intelsath/Cypher/hashbank/LCD/images/keyboard_test.png

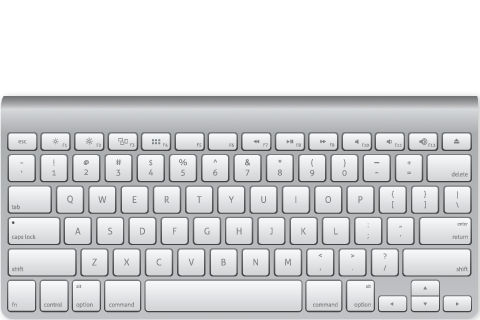
hashbank/LCD/images/keyboard_test.png
