intelsath/Cypher/hashbank_client_app/command table.docx

Hash Bank/PC | Command
Generar address bitcoin | HB_GENBTC
Generar address bitcoin cash | HB_GENBCH
Generar address litecoin | HB_GENLTC
Generar address ethereum | HB_GENETH
Generar address ripple | HB_GENXRP
Generar transaction bitcoin | HB_TXNBTC
Generar transaction bitcoin cash | HB_TXNBCH
Generar transaction litecoin | HB_TXNLTC
Generar transaction ethereum | HB_TXNETH
Generar transaction ripple | HB_TXNXRP
Volver a enviar address | HB_RSNDAD
Volver a enviar transaction | HB_RSNDTX
Enviar la cantidad de bytes que debe esperar | HB_SNDBYT
Información recibida correctamente | HB_INFOOK
