intelsath/Cypher/hashbank/LCD/images/background.png

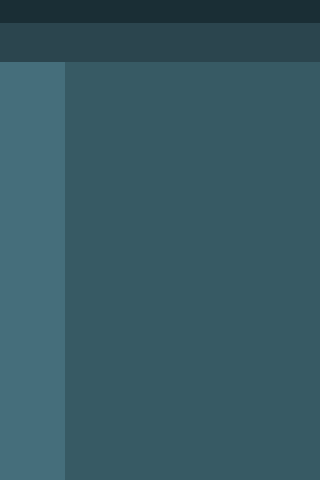
hashbank/LCD/images/background.png
