intelsath/Cypher/hashbank/LCD/images/fpscounter1.png

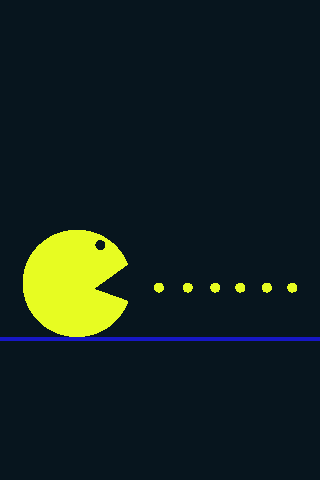
hashbank/LCD/images/fpscounter1.png
