intelsath/Cypher/hashbank_client_app/images/background.jpg

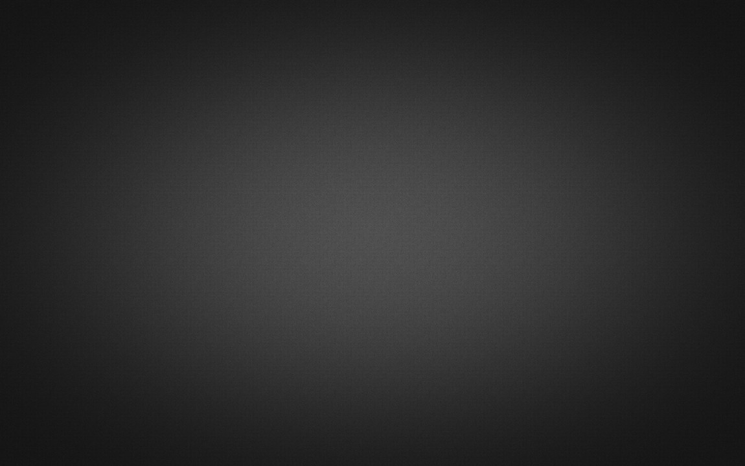
hashbank_client_app/images/background.jpg
