intelsath/Cypher/hashbank_client_app/images/bitcoin.png

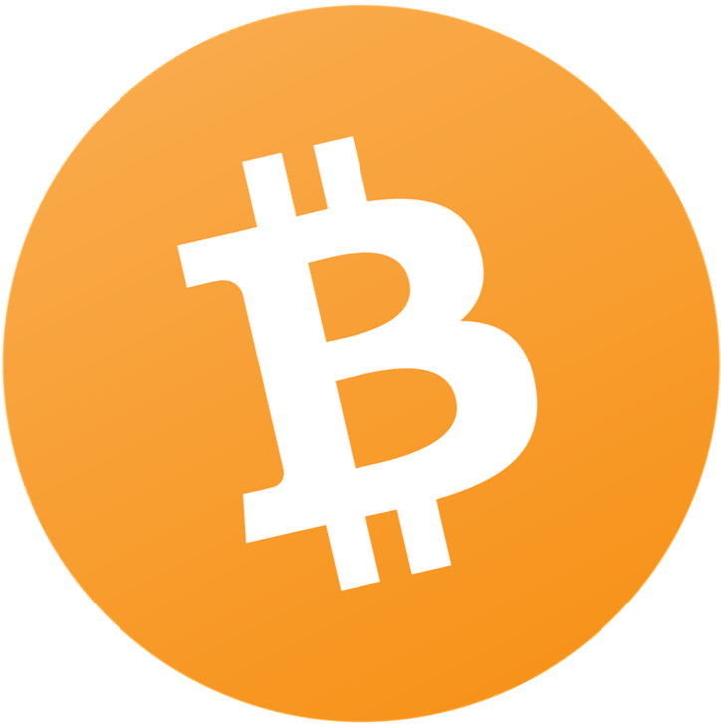
hashbank_client_app/images/bitcoin.png
