intelsath/Cypher/hashbank_client_app/images/bitcoin_cash.png

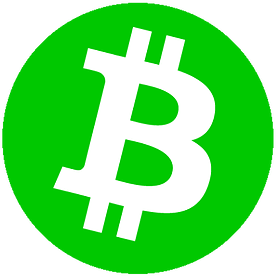
hashbank_client_app/images/bitcoin_cash.png
