intelsath/Cypher/hashbank_client_app/images/litecoin.png

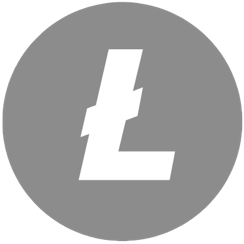
hashbank_client_app/images/litecoin.png
