intelsath/Cypher/hashbank_client_app/images/ripple.png

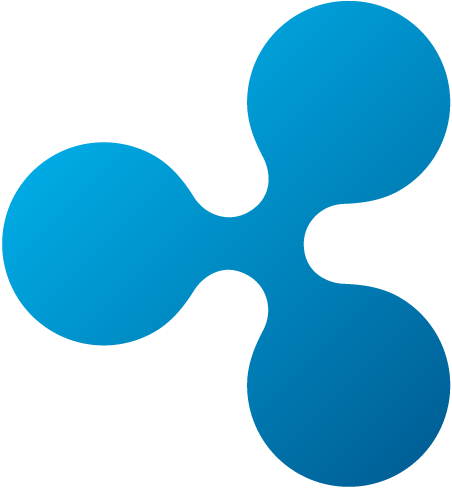
hashbank_client_app/images/ripple.png
