intelsath/Cypher/hashbank/Eagle/Cypher-BOM.xls

Qty | Part Reference | Part Number | MFGR | Distributor NO | DESCRIPTION | FOOTPRINT | DNI
2 | ANTENNA1, ANTENNA2 | 709150001030006 | AVX Corporation | 478-10942-1-ND | CONN PIN SPRING LOAD 3.0MM | B254
1 | C1 | CL05B154KO5NNNC | Samsung Electro-Mechanics | 1276-6651-1-ND | CAP CER 0.15UF 16V X7R 0402 | 0402
1 | C2 | GRM21BR60J476ME15L | Murata Electronics North America | 490-9960-1-ND | CAP CER 47UF 6.3V X5R 0805 | 0805
4 | C3, C23, C25, C34 | 02016D105KAT2A | AVX Corporation | 478-10772-1-ND | CAP CER 1UF 6.3V X5R 0201 | 0201
4 | C4, C6, C7, C14 | GRJ155R60J106ME11D | Murata Electronics North America | 490-13211-1-ND | CAP CER 10UF 6.3V X5R 0402 | 0402
1 | C5 | GRM0335C1H121JA01D | Murata Electronics North America | 490-7221-1-ND | CAP CER 120PF 50V C0G/NP0 0201 | 0201
1 | C8 | GCM033R71A103KA03D | Murata Electronics North America | 490-6040-1-ND | CAP CER 10000PF 10V X7R 0201 | 0201
8 | C9, C10, C13, C17, C18, C20, C35, C36 | CL03A104KO3NNNC | Samsung Electro-Mechanics | 1276-1319-1-ND | CAP CER 0.1UF 16V X5R 0201 | 0201
4 | C11, C12, C21, C22 | GRM0335C1H120GA01D | Murata Electronics North America | 490-11308-1-ND | CAP CER 12PF 50V C0G/NP0 0201 | 0201
3 | C15, C16, C19 | GRM033R71C222KA88D | Murata Electronics North America | 490-3190-1-ND | CAP CER 2200PF 16V X7R 0201 | 0201
1 | C24 | CL10A475KQ8NNNC | Samsung Electro-Mechanics | 1276-1045-1-ND | CAP CER 4.7UF 6.3V X5R 0603 | 0603
2 | C26, C27 | C0603C102J5RACTU | KEMET | 399-1083-1-ND | CAP CER 1000PF 50V X7R 0603 | 0603
2 | C28, C29 | TMK063CG181JTHF | Taiyo Yuden | 587-3800-1-ND | CAP CER 180PF 25V NP0 0201 | 0201
2 | C30, C31 | GRM0335C1H330GA01D | Murata Electronics North America | 490-11325-1-ND | CAP CER 33PF 50V C0G/NP0 0201 | 0201
2 | C32, C33 | CC0201JRNPO9BN820 | Yageo | 311-3684-1-ND | CAP CER 82PF 50V NPO 0201 | 0201
1 | D1 | APGA1602CGC/KA | Kingbright | 754-1820-1-ND | LED GREEN CLEAR CHIP SMD R/A | 0603
1 | J1 | ZX62-AB-5PA(31) | Hirose Electric Co Ltd | H125279CT-ND | CONN RCPT USB MICRO AB SMD R/A | Right-angle, PCB wire
1 | J2 | SM02B-SRSS-TB(LF)(SN) | JST Sales America Inc. | 455-1802-1-ND | CONN HEADER SH 2POS SIDE 1MM TIN | 2SMD, Right Angle
1 | L2 | CIG22L2R2MNE | Samsung Electro-Mechanics | 1276-6211-1-ND | FIXED IND 2.2UH 1.3A 80 MOHM SMD | 1008
1 | L1 | CIG22L4R7MNE | Samsung Electro-Mechanics | 1276-6213-1-ND | FIXED IND 4.7UH 1.1A 110 MOHM | 1008
2 | L3, L4 | LQB15NNR56J10D | Murata Electronics North America | 490-14690-1-ND | FIXED IND 560NH 300MA 730 MOHM | 0402
1 | Q1 | MMBT2222ALP4-7B | Diodes Incorporated | MMBT2222ALP4-7BDICT-ND | TRANS NPN 40V 0.6A 3DFN | X2-DFN1006-3
1 | R1 | ERJ-1GNF8063C | Panasonic Electronic Components | P123167CT-ND | RES SMD 806K OHM 1% 1/20W 0201 | 0201
1 | R2 | ERJ-1GNF1743C | Panasonic Electronic Components | P122780CT-ND | RES SMD 174K OHM 1% 1/20W 0201 | 0201
1 | R3 | ERJ-1GNJ105C | Panasonic Electronic Components | P123224CT-ND | RES SMD 1M OHM 5% 1/20W 0201 | 0201
14 | R4, R5, R9, R17, R18, R19, R20, R21, R22, R23, R24, R25, R26, R27 | ERJ-1GNJ103C | Panasonic Electronic Components | P123222CT-ND | RES SMD 10K OHM 5% 1/20W 0201 | 0201
2 | R6, R14 | ERJ-1GNF1603C | Panasonic Electronic Components | P122760CT-ND | RES SMD 160K OHM 1% 1/20W 0201 | 0201
2 | R7, R12 | ERJ-1GNF2403C | Panasonic Electronic Components | P122859CT-ND | RES SMD 240K OHM 1% 1/20W 0201 | 0201
1 | R8 | ERJ-2GEJ161X | Panasonic Electronic Components | P160JCT-ND | RES SMD 160 OHM 5% 1/10W 0402 | 0402
1 | R10 | ERJ-1GNF1001C | Panasonic Electronic Components | P122413CT-ND | RES SMD 1K OHM 1% 1/20W 0201 | 0201
1 | R11 | ERJ-1GNF7503C | Panasonic Electronic Components | P123152CT-ND | RES SMD 750K OHM 1% 1/20W 0201 | 0201
1 | R13 | ERJ-1GNF8453C | Panasonic Electronic Components | P123182CT-ND | RES SMD 845K OHM 1% 1/20W 0201 | 0201
1 | R15 | ERJ-1GNF5903C | Panasonic Electronic Components | P123092CT-ND | RES SMD 590K OHM 1% 1/20W 0201 | 0201
1 | R16 | ERJ-1GNF4123C | Panasonic Electronic Components | P122999CT-ND | RES SMD 412K OHM 1% 1/20W 0201 | 0201
2 | R28, R29 | ERJ-1GNF1501C | Panasonic Electronic Components | P122743CT-ND | RES SMD 1.5K OHM 1% 1/20W 0201 | 0201
1 | R30, R31 | ERJ-2GEJ152X | Panasonic Electronic Components | P1.5KJCT-ND | RES SMD 1.5K OHM 5% 1/10W 0402 | 0402
1 | RN1 | EXB-V4V102JV | Panasonic Electronic Components | Y2102CT-ND | RES ARRAY 2 RES 1K OHM 0606 | 0606
1 | RN2 | EXB-N8V100JX | Panasonic Electronic Components | Y10100CT-ND | RES ARRAY 4 RES 10 OHM 0804 | 2012
1 | S1 | EVQ-P7J01P | Panasonic Electronic Components | P16767CT-ND | SWITCH TACTILE SPST-NO 0.05A 12V | SPST-NO
1 | U1 | LTC2954CDDB-1#TRMPBF | Linear Technology/Analog Devices | LTC2954CDDB-1#TRMPBFCT-ND | IC PUSH BUTTON ON/OFF CTRLR 8DFN | 8DFN (3x2)
1 | U2 | LTC3558EUD#PBF | Linear Technology/Analog Devices | LTC3558EUD#PBF-ND | IC USB BATTERY CHARGER 20-QFN | 20QFN (3x3)
1 | U3 | FT232RQ-REEL | FTDI, Future Technology Devices International Ltd | 768-1008-1-ND | IC USB FS SERIAL UART 32-QFN | 32QFN (5x5)
1 | U4 | OSD3358-512M-BSM | Octavo Systems LLC | 1676-1002-ND | SiP (AM335x, TPS65217C PMIC, TI TL5209 LDO) 21mm 256 BALL BGA | 256BGA (21x21)
1 | U5 | SN74LVC1G07DSFR | Texas Instruments | 296-29520-1-ND | IC BUFFER NON-INVERT 5.5V 6SON | 6-SON (1x1)
1 | U7 | LSM6DS33TR | STMicroelectronics | 497-15996-1-ND | IMU ACCEL/GYRO I2C/SPI 16LGA | 16-LGA (3x3)
1 | U6 | AT97SC3205T-G3M4C-10 | Microchip Technology | AT97SC3205T-G3M4C-10CT-ND | FF COM I2C TPM 4X4 32VQFN UEK | 32VQFN(4x4)
1 | U8 | PN7150B0HN/C11002E | NXP USA Inc. | 568-13911-ND | RFID Reader IC 13.56MHz HVQFN | 40-VFQFN (6x6)
1 | XU1 | DF37B-10DP-0.4V(53) | Hirose Electric Co Ltd | H11832CT-ND | CONN HDR 10POS 0.4MM SMD GOLD
1 | XU2 | 62684-502100ALF | Amphenol FCI | 609-1202-1-ND | LCD FPC/FFC Connector 0.5mm pitch 50 pin TOP | SMD 50 pins 0.5mm pitch
1 | XU3 | 0472192001 | Molex, LLC | WM6698CT-ND | CONN MICRO SD CARD HINGED TYPE | 8pos microSD
1 | Y1 | TSX-3225 24.0000MF15X-AC6 | EPSON | SER4180CT-ND | CRYSTAL 24.00 MHZ 9.0PF SMD | 4SMD
1 | Y2 | XRCGB27M120F3M10R0 | Murata Electronics North America | 490-8578-1-ND | CRYSTAL 27.1200MHZ 10PF SMD | 4SMD
