intelsath/Cypher/Hardware/Inventor/Button Cap void.stl

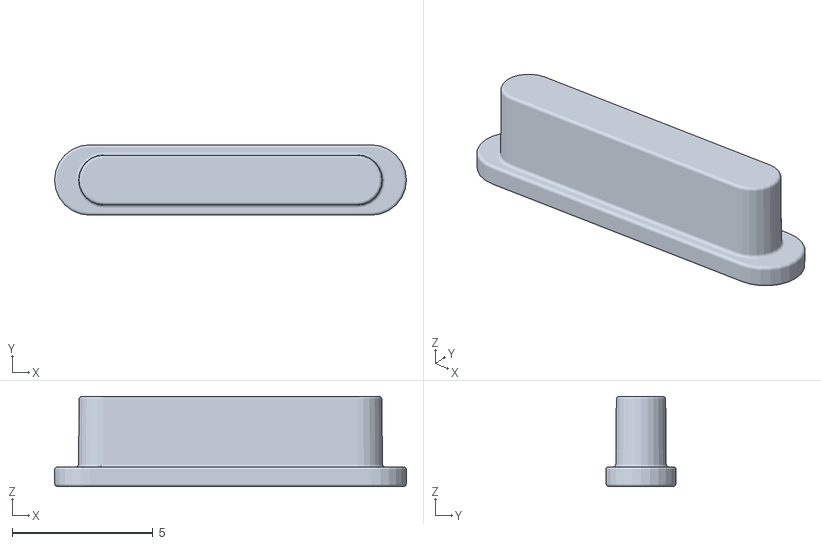
[picture p9: CAD file, 2020-03-15]
Hardware/Inventor/Button Cap void.stl
12.5 x 2.50 x 3.20
