intelsath/Cypher/Hardware/Inventor/Casing for cover.stp

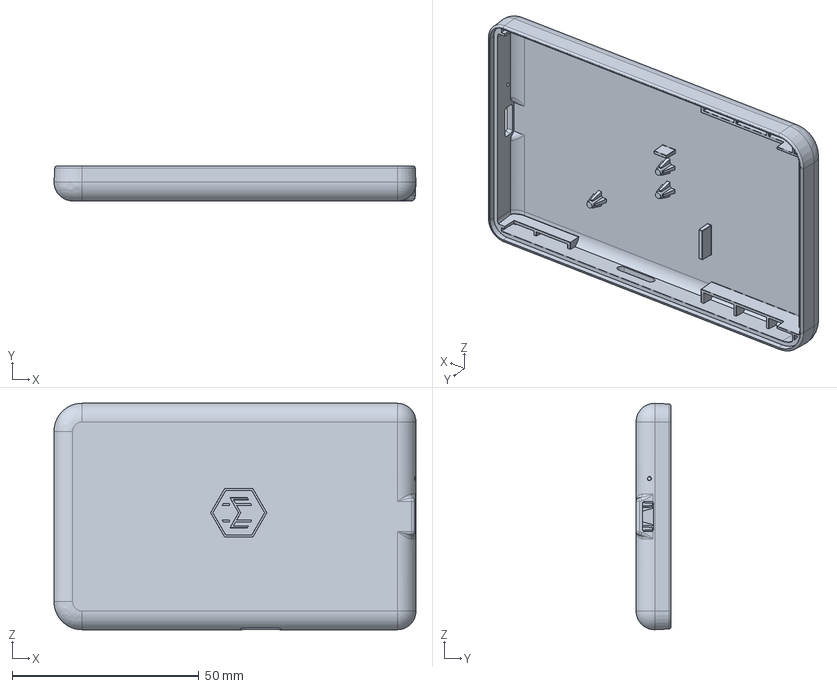
[picture p10: CAD file, 2020-03-15]
Hardware/Inventor/Casing for cover.stp
96.8 x 9.32 x 60.6 mm
