intelsath/Cypher/(list of files, cad)

Other CAD files:
Hardware/Inventor/Button Cap.stp
Hardware/Inventor/LCD+Cover.dwg
Hardware/Inventor/OldVersions/LCD+Cover.0003.dwg
Hardware/Inventor/0603 LED v7.ipt
Hardware/Inventor/Antenna.ipt
Hardware/Inventor/Assembled_PCB.iam
Hardware/Inventor/Battery.ipt
Hardware/Inventor/Button Cap.ipt
Hardware/Inventor/Button Cap.stl
Hardware/Inventor/Casing (Back).ipt
Hardware/Inventor/Casing for cover.ipt
Hardware/Inventor/Casing for cover.stl
Hardware/Inventor/ColdStorageCasing.iam
Hardware/Inventor/Crystal 3225.ipt
Hardware/Inventor/LCD+Cover.ipt
Hardware/Inventor/LCD-Connector.ipt
Hardware/Inventor/LCD-cable.ipt
Hardware/Inventor/LCD.ipt
Hardware/Inventor/LED Pipe.ipt
Hardware/Inventor/MegahashColdStorage.iam
Hardware/Inventor/MegahashColdStorage_V3.iam
Hardware/Inventor/MicroSD-holder.ipt
Hardware/Inventor/Multi-Inno_3.5in_LCD.ipt
Hardware/Inventor/OldVersions/0603 LED v7.0001.ipt
Hardware/Inventor/OldVersions/Antenna.0001.ipt
Hardware/Inventor/OldVersions/Assembled_PCB.0011.iam
Hardware/Inventor/OldVersions/Battery.0009.ipt
Hardware/Inventor/OldVersions/Button Cap.0016.ipt
Hardware/Inventor/OldVersions/Casing (Back).0084.ipt
Hardware/Inventor/OldVersions/Casing (Front).0019.ipt
Hardware/Inventor/OldVersions/Casing for cover.0059.ipt
Hardware/Inventor/OldVersions/ColdStorageCasing.0002.iam
Hardware/Inventor/OldVersions/CryptoWallet.0050.iam
Hardware/Inventor/OldVersions/LCD+Cover.0006.ipt
Hardware/Inventor/OldVersions/LCD.0002.ipt
Hardware/Inventor/OldVersions/LCD.0005.iam
Hardware/Inventor/OldVersions/LED Pipe.0003.ipt
Hardware/Inventor/OldVersions/MegahashColdStorage.0019.iam
Hardware/Inventor/OldVersions/MegahashColdStorage_V3.0025.iam
Hardware/Inventor/OldVersions/Multi-Inno_3.5in_LCD.0002.ipt
Hardware/Inventor/OldVersions/PCB.0014.ipt
Hardware/Inventor/OldVersions/Push-button.0002.ipt
Hardware/Inventor/OldVersions/SiP.0006.ipt
Hardware/Inventor/OldVersions/Test.0002.ipt
Hardware/Inventor/OldVersions/Touchcreen+Cover.0002.ipt
Hardware/Inventor/OldVersions/micro_usb_connector.0004.iam
Hardware/Inventor/PCB.ipt
Hardware/Inventor/Pogo-pin.ipt
Hardware/Inventor/Push-button.ipt
Hardware/Inventor/QFN-24 3x3 0.4mm.ipt
Hardware/Inventor/QFN24(4X4).ipt
Hardware/Inventor/QFN32.ipt
Hardware/Inventor/RightAngleLED.ipt
Hardware/Inventor/SHR-02V-S-B.ipt
Hardware/Inventor/SM02B-SRSS-TB.ipt
Hardware/Inventor/SiP.ipt
Hardware/Inventor/Touchcreen+Cover.ipt
Hardware/Inventor/Touchscreen_Connector.ipt
Hardware/Inventor/micro_usb_connector.iam
Hardware/Inventor/shield.ipt
Hardware/Inventor/socket_housing.ipt
Hardware/Inventor/socket_plate.ipt
Hardware/Inventor/terminal.ipt
