intelsath/Cypher/Hardware/Inventor/LCD+Cover.pdf

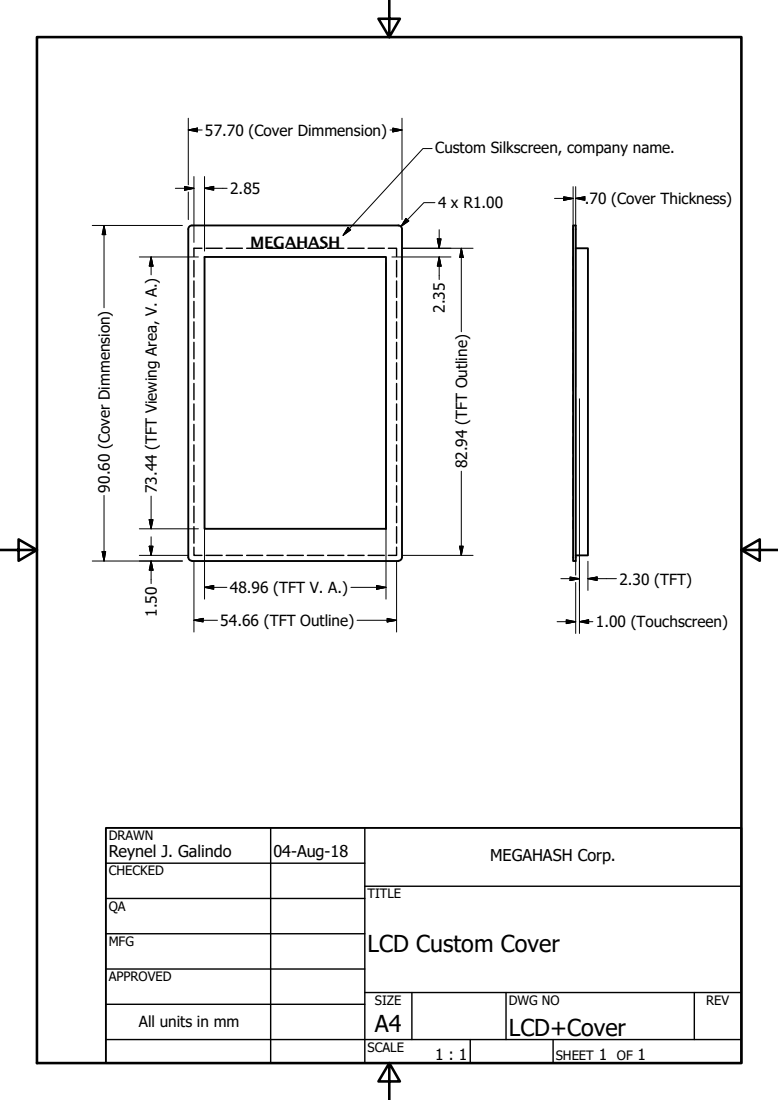
[picture p15: page 1]
SHEET 1 OF 1; DRAWN; CHECKED; MFG; APPROVED; Reynel J. Galindo; 04-Aug-18; DWG NO LCD+Cover; TITLE; SIZE A4; SCALE; MEGAHASH Corp.; REV; 54.66 (TFT Outline); utlin; Vie; win; Are; 48.96 (TFT V. A.); er Dim; sio; 57.70 (Cover Dimmension); 2.30 (TFT); 1.00 (Touchscreen); .70 (Cover Thickness); MEGAHASH

Custom Silkscreen, company name.

LCD Custom Cover

All units in mm
