intelsath/Cypher/Hardware/Eagle/Cypher v0.3/Cypher - v0.3 - Assembly drawing.pdf

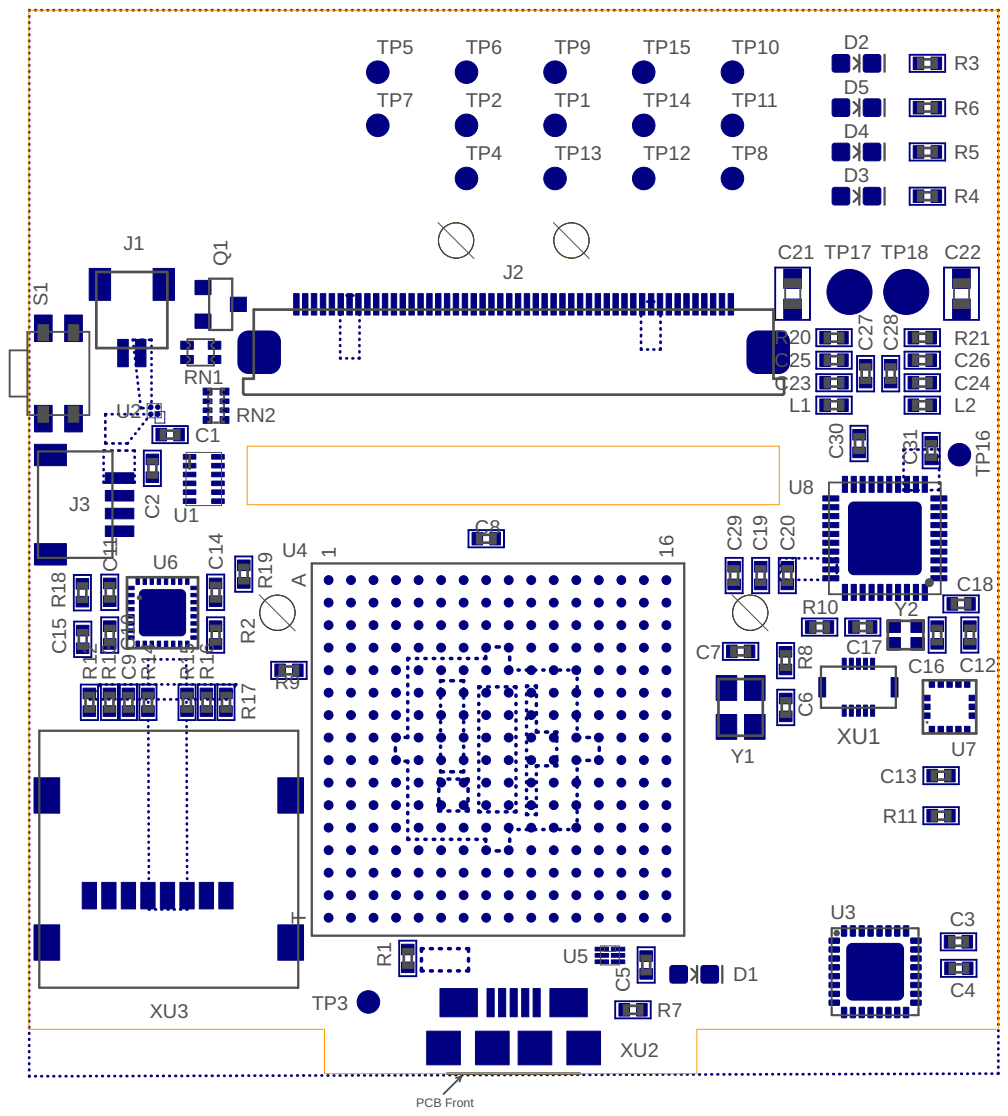
[picture p16: page 1]
