intelsath/Cypher/Hardware/Eagle/Cypher v0.3/Cypher - V0.3.bot.pdf

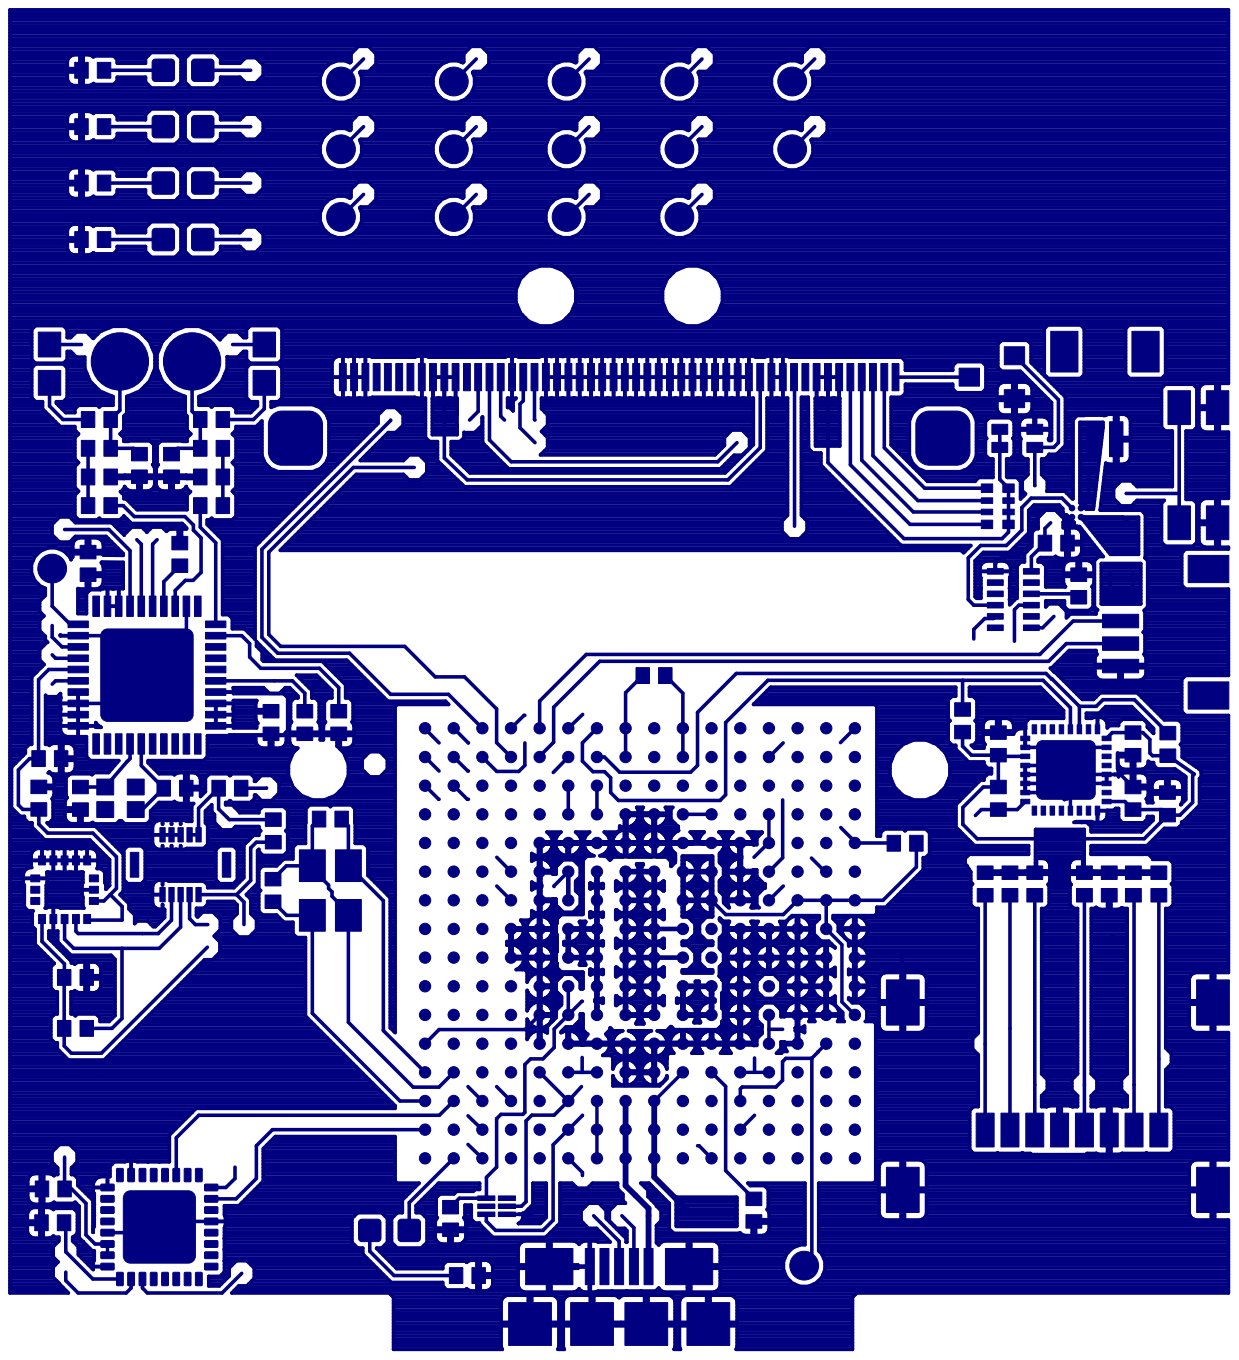
[picture p17: page 1]
