intelsath/Cypher/Hardware/Eagle/Cypher v0.3/Cypher - V0.3.signal.pdf

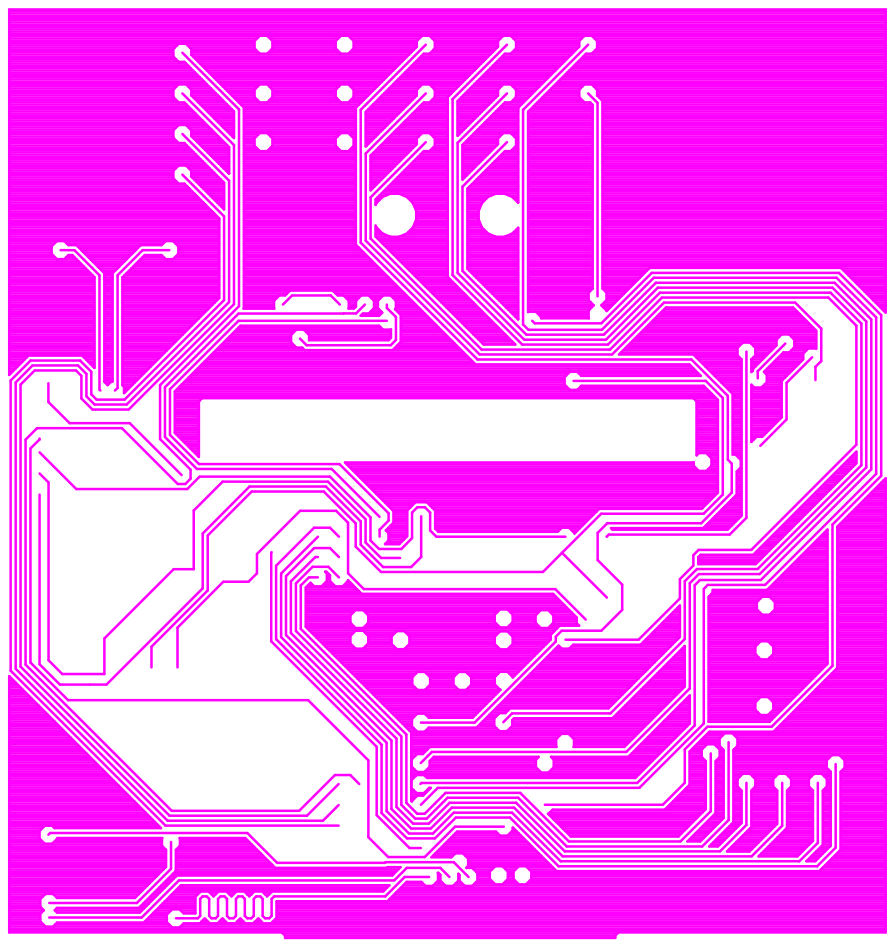
[picture p18: page 1]
