intelsath/Cypher/Hardware/Eagle/Cypher v0.3/Cypher - V0.3.top.pdf

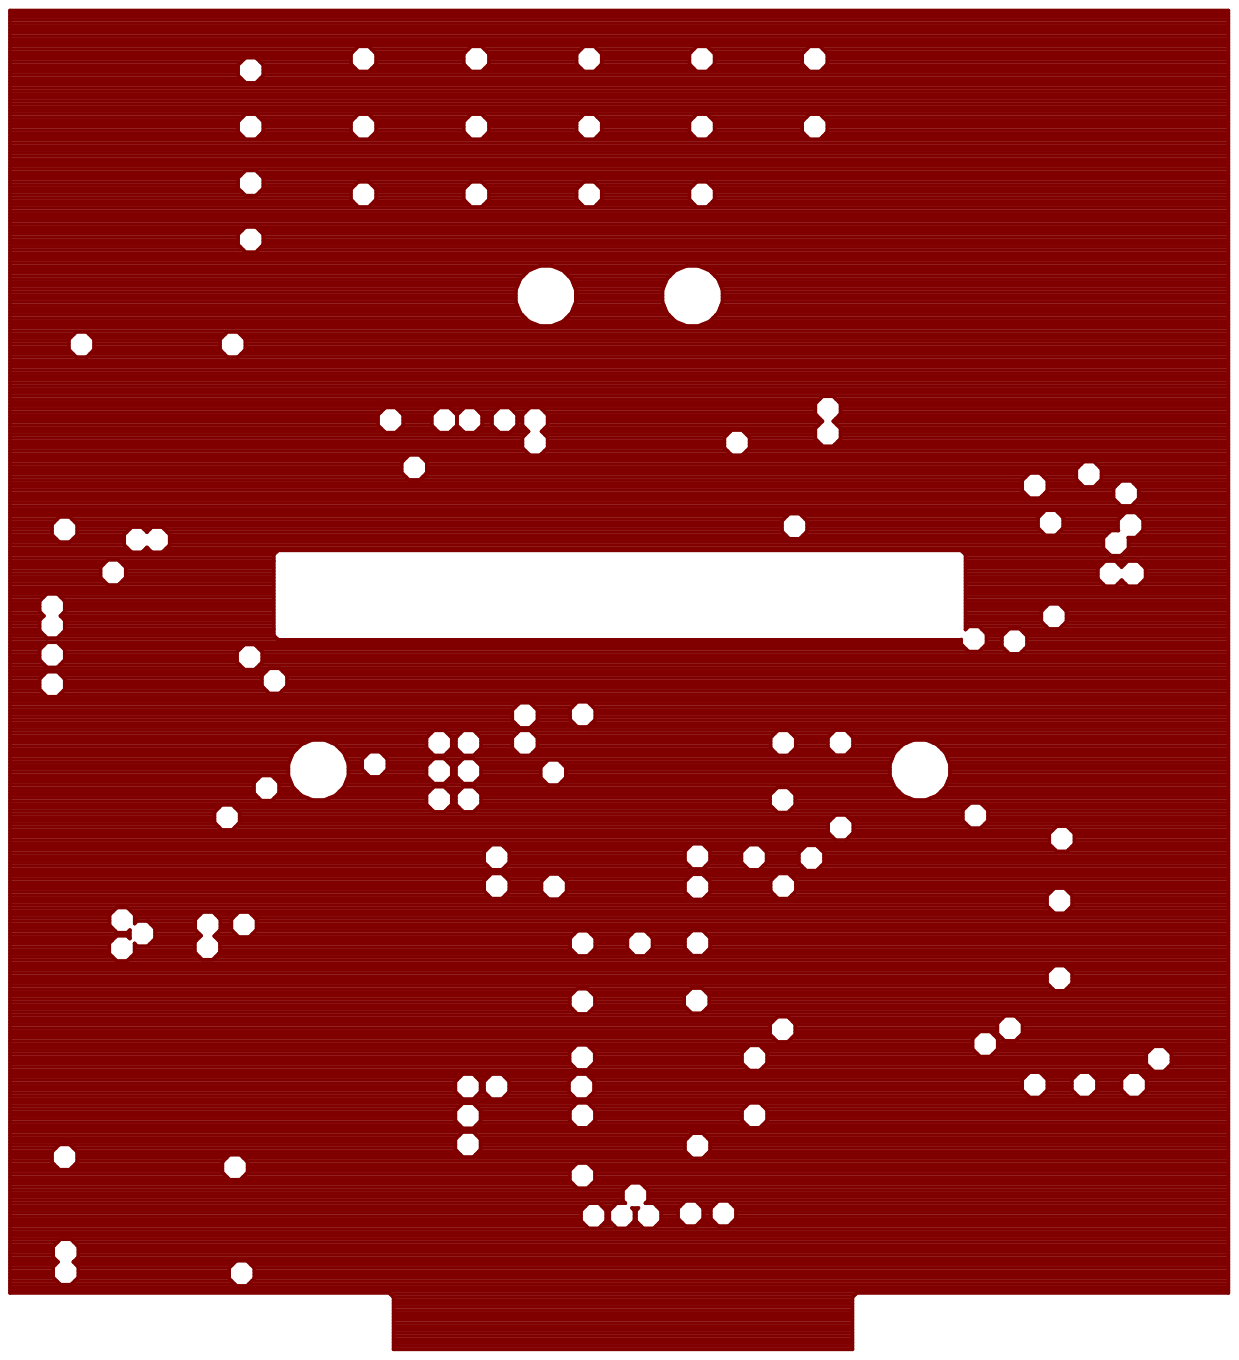
[picture p19: page 1]
