intelsath/Cypher/Hardware/Eagle/Cypher v0.3/Cypher - V0.3.vcc.pdf

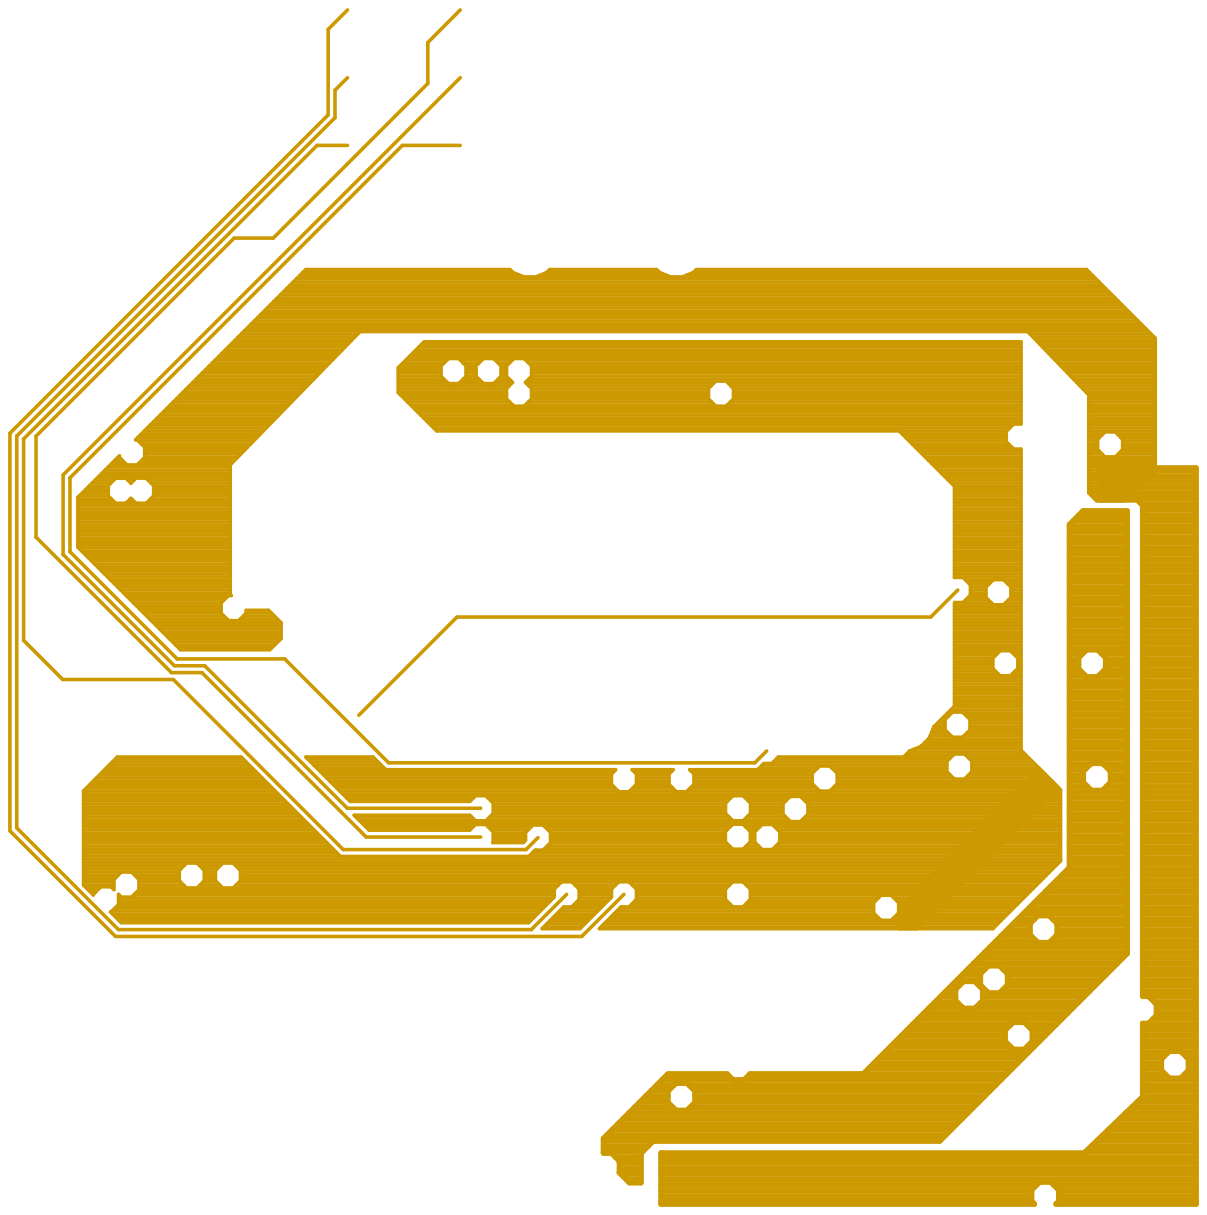
[picture p20: page 1]
