intelsath/Cypher/Hardware/Eagle/Cypher v0.3/Cypher - V1.3.1.pdf

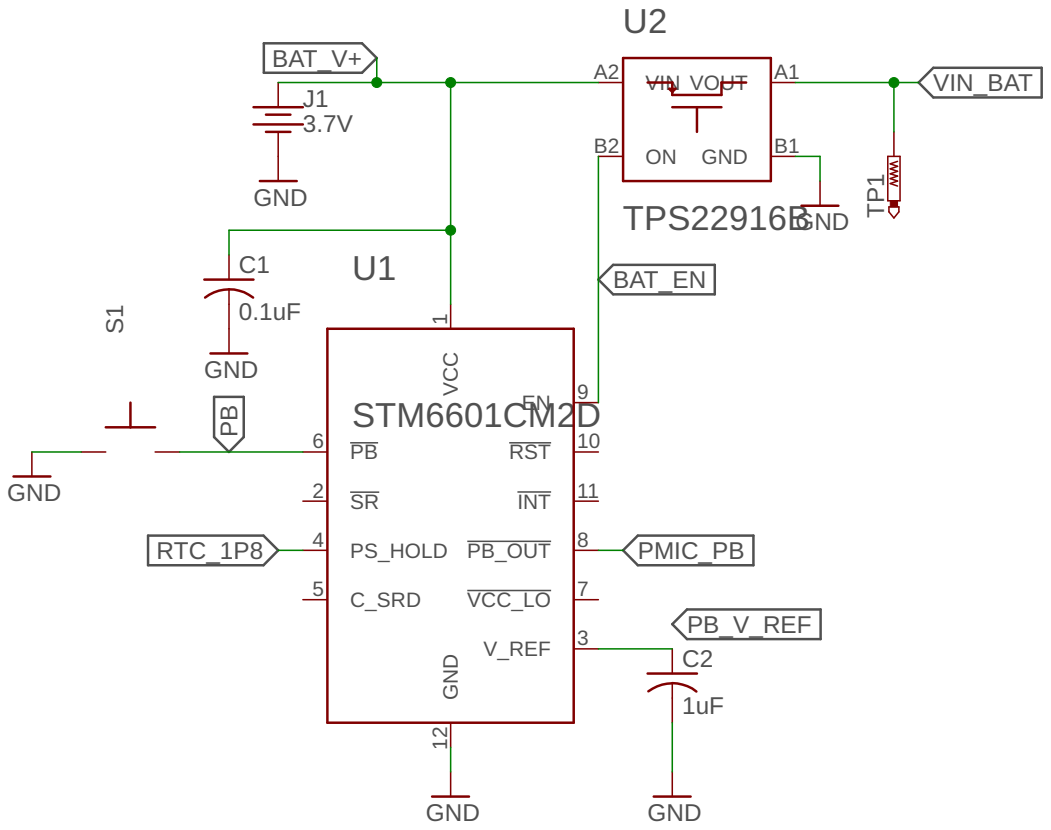
[picture p21: page 1]

REV:

Date: 21-Feb-19 4:08 PM | Sheet: 1/1
