intelsath/Cypher/Hardware/Eagle/Cypher v0.3/Cypher - V0.3.6.pdf

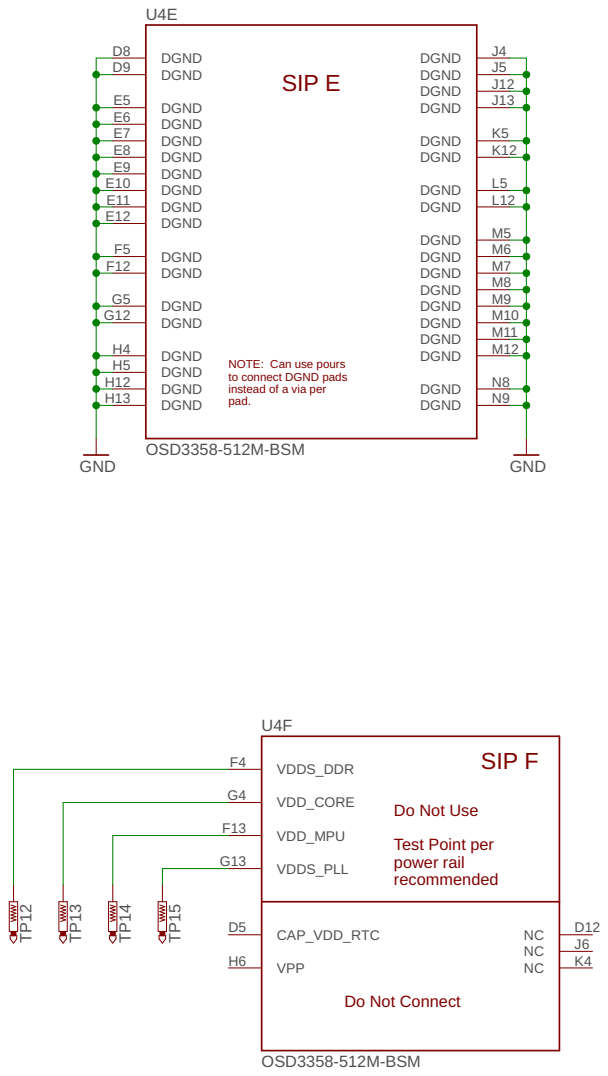
[picture p22: page 1]

D9 | J5
E5 | J12

E8 | K12
E9 | L5

NOTE: Can use pours
to connect DGND pads
instead of a via per pad.

Do Not Use Test Point per power rail recommended

Document Number: | REV:

Date: 21-Feb-19 4:08 PM | Sheet: 1/1
