intelsath/Cypher/Hardware/Eagle/Cypher v0.3/Cypher - V0.3.1.pdf

REV:

Date: 21-Feb-19 4:08 PM | Sheet: 1/1
