intelsath/Cypher/Hardware/Eagle/Cypher v0.3/Cypher - V0.3.3.pdf

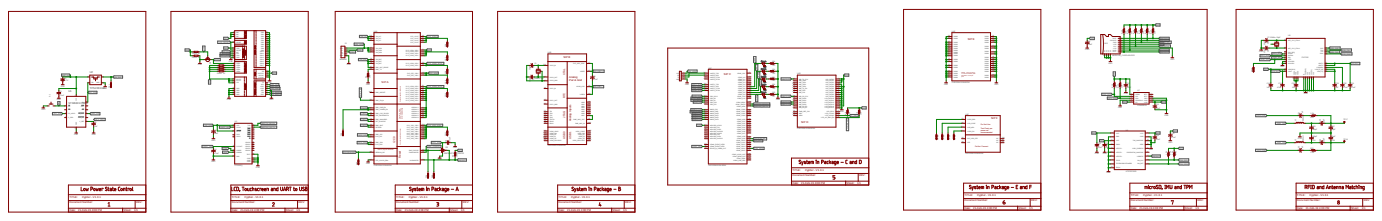
[picture p23: page 1]
