intelsath/Cypher/Hardware/Eagle/Cypher v0.3/Cypher - V0.3.5.pdf

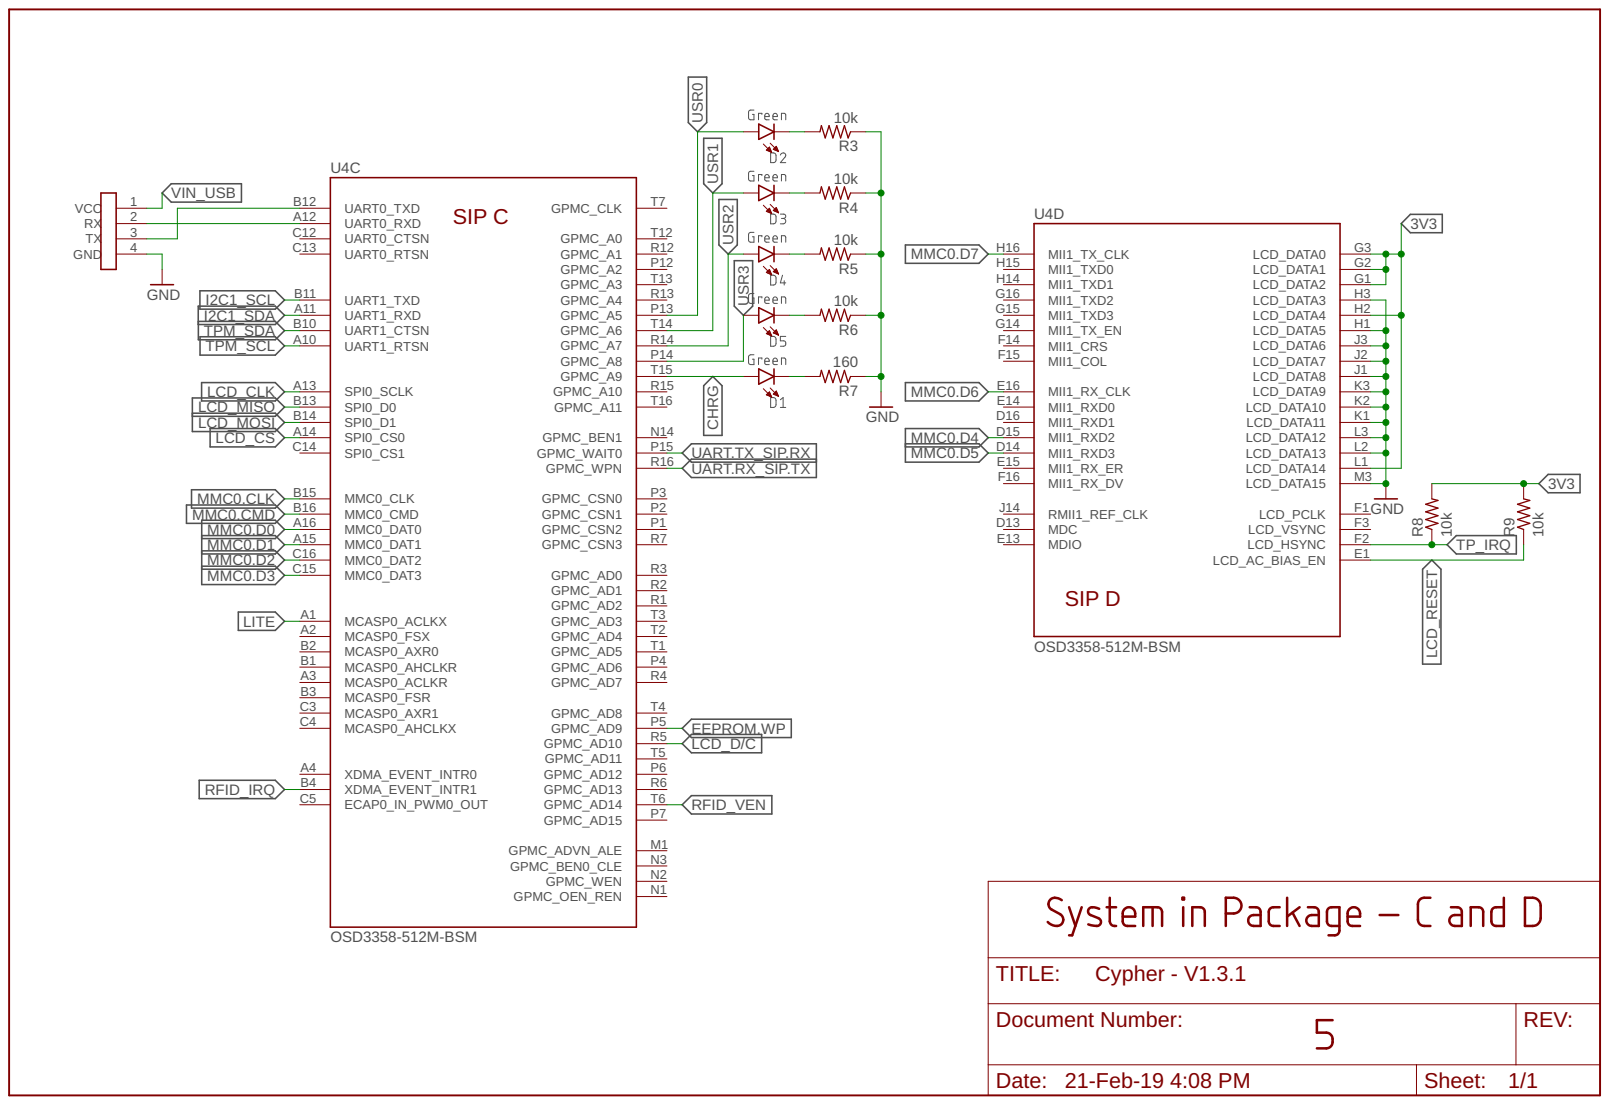
[picture p24: page 1]

REV:

Date: 21-Feb-19 4:08 PM | Sheet: 1/1
