intelsath/Cypher/Hardware/Eagle/Cypher v0.3/Cypher - V0.3.8.pdf

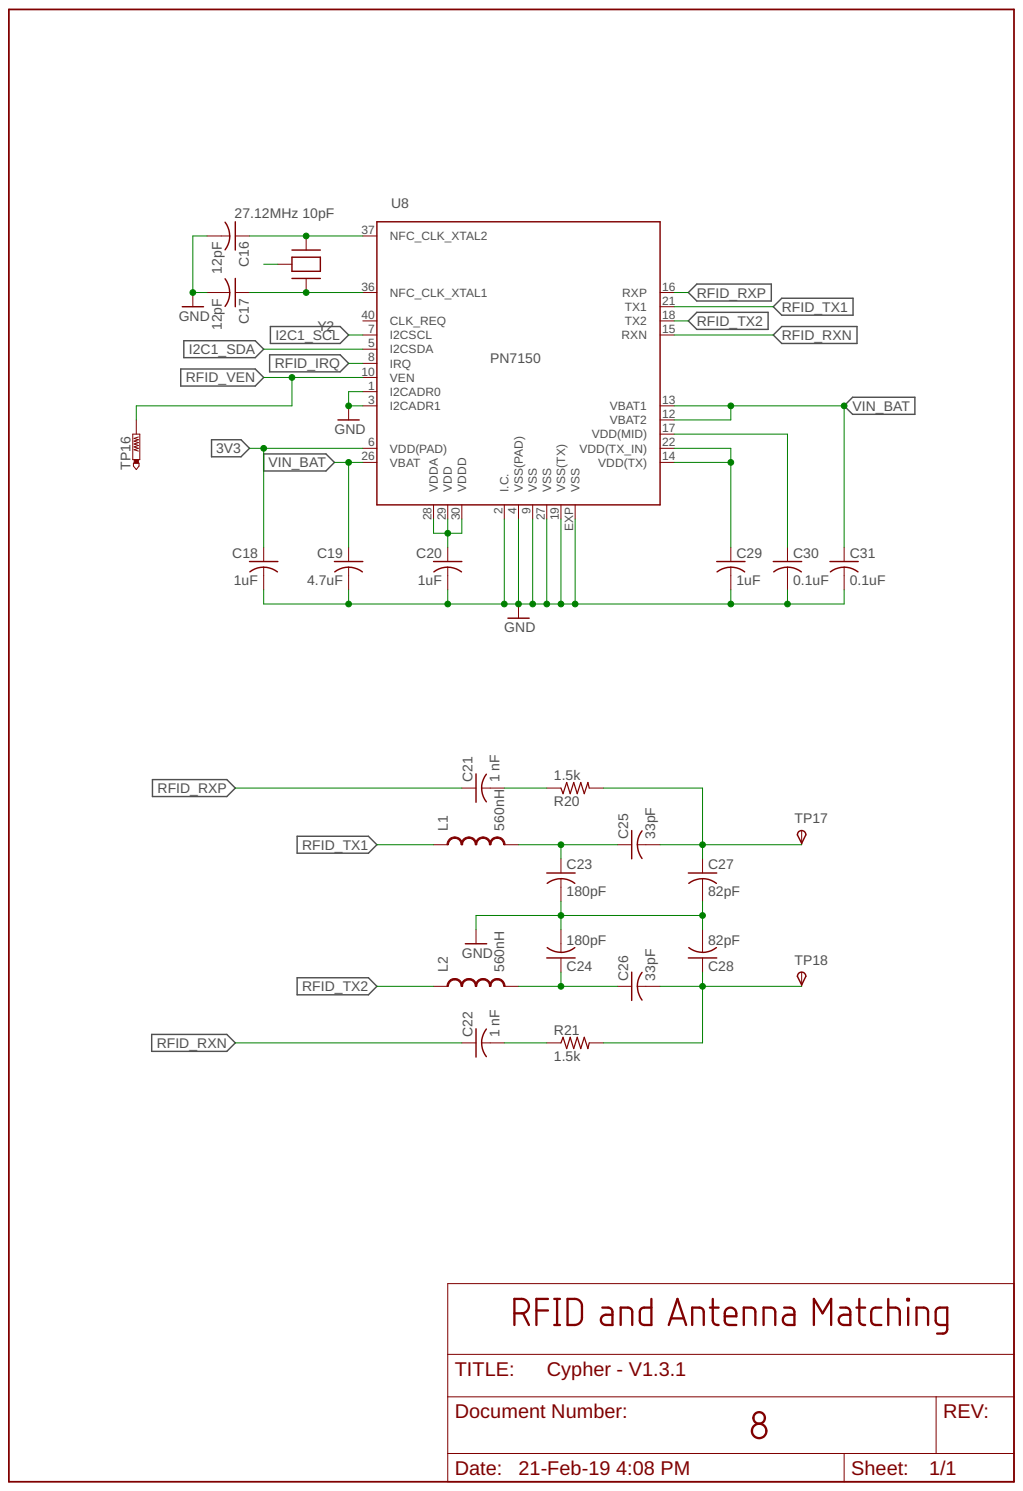
[picture p25: page 1]

27 VSS(TX) 19 VDD(TX) 14 VDD(TX_IN) 22 VDD(MID) 17 VBAT2

Document Number: | REV:

Date: 21-Feb-19 4:08 PM | Sheet: 1/1
