intelsath/Cypher/hashbank/Eagle/Cypher.brd

## EAGLE design hashbank/Eagle/Cypher.brd (2020-03-15)

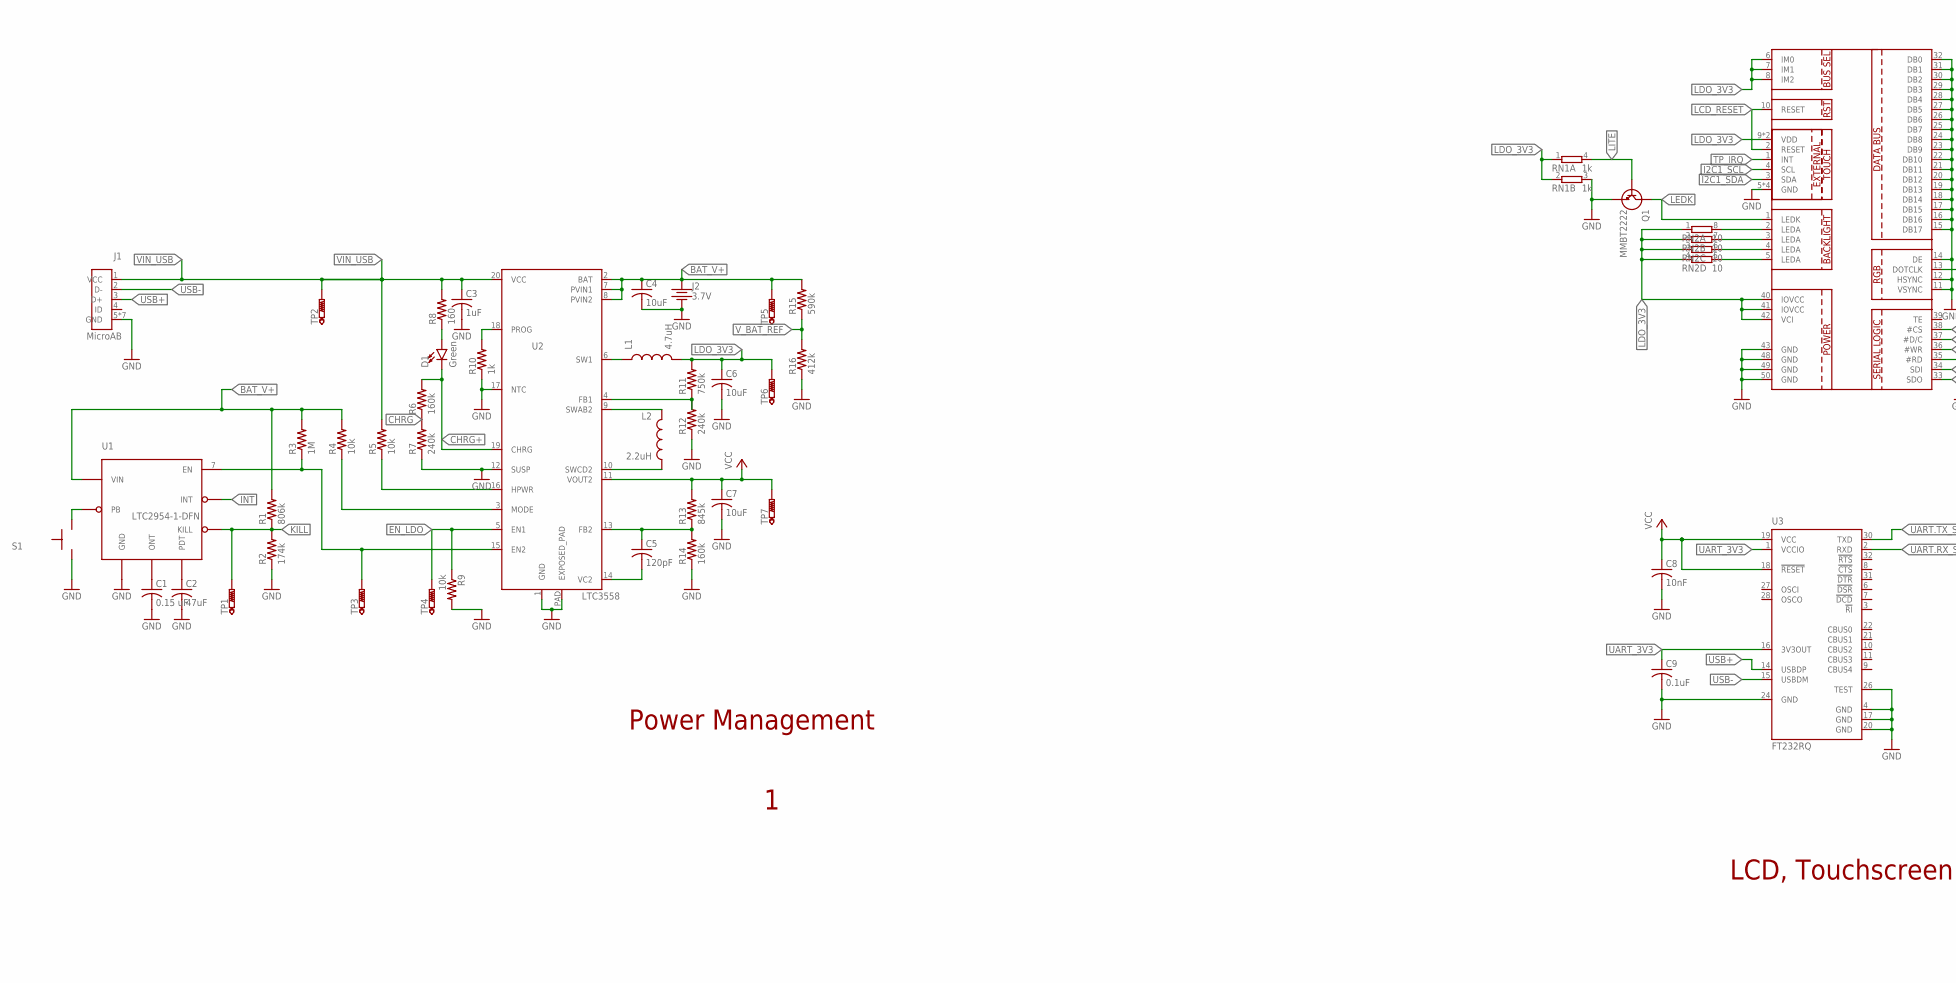
[picture p26: schematic Cypher.sch, part in row 1, column 1]

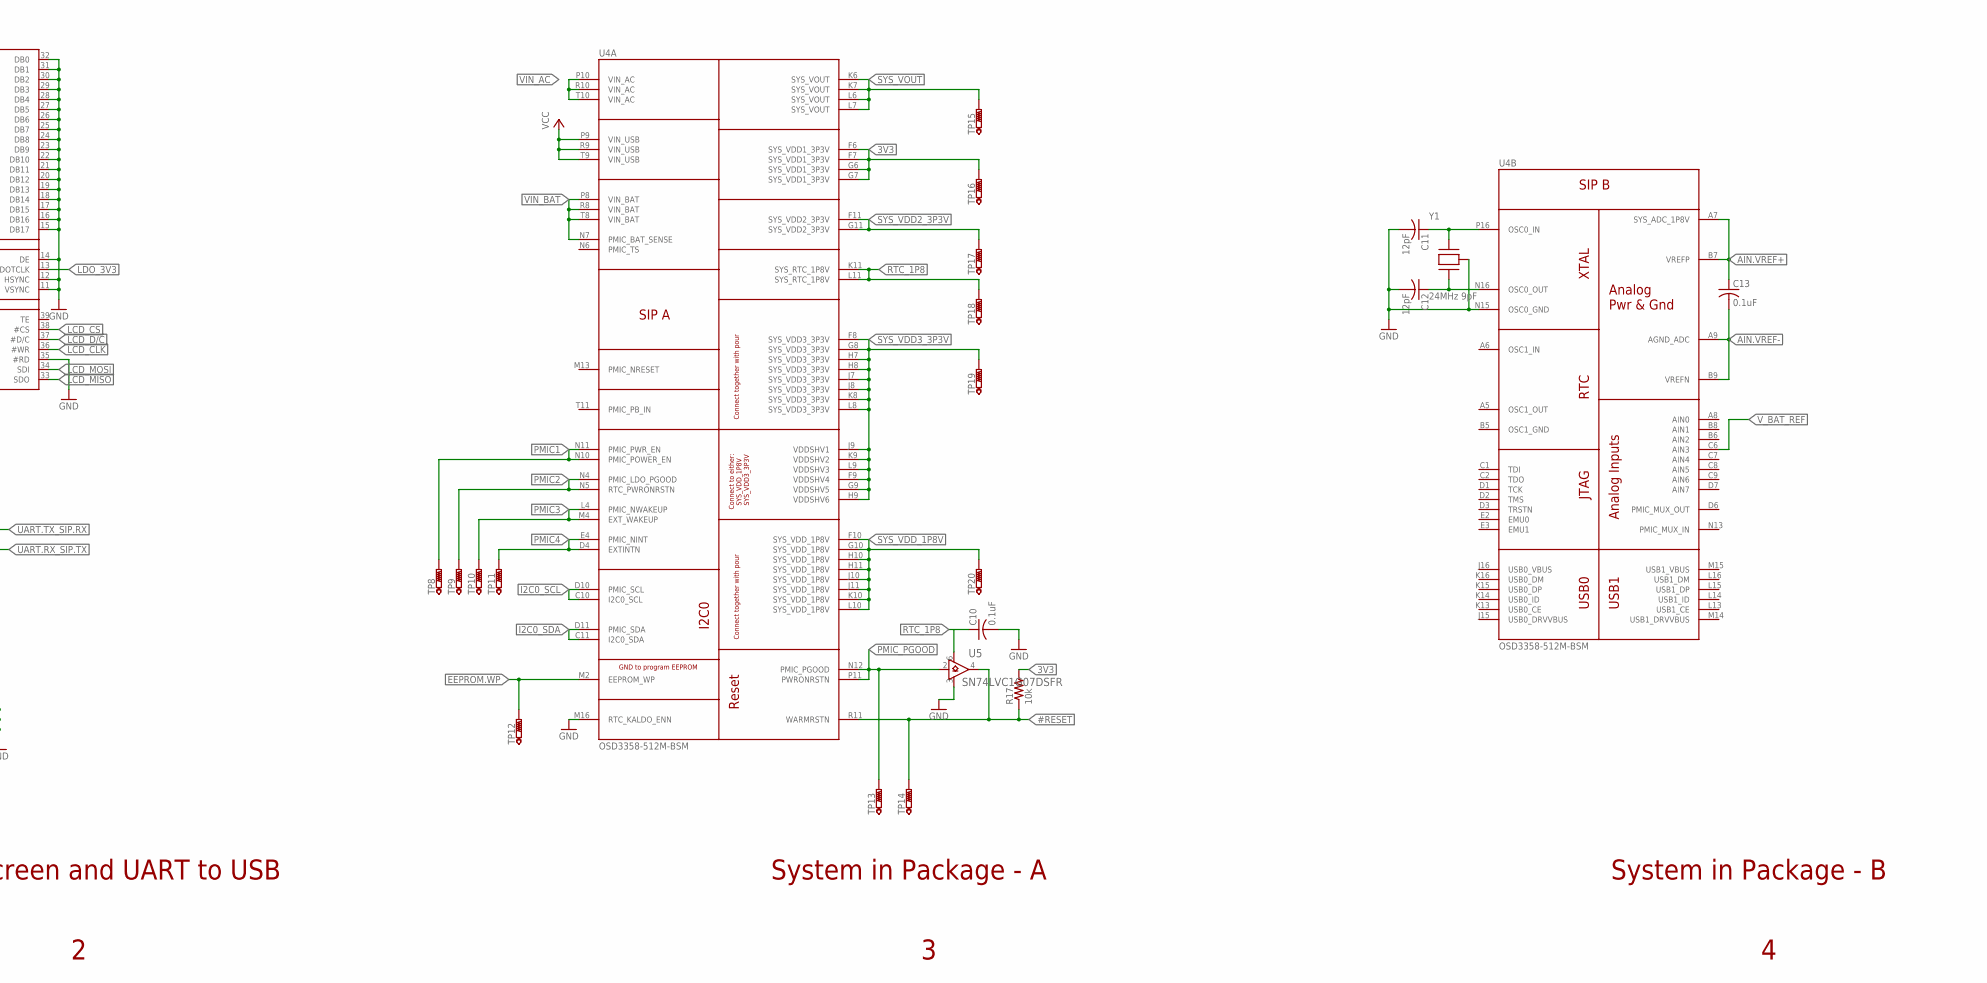
[picture p27: schematic Cypher.sch, part in row 1, column 2]

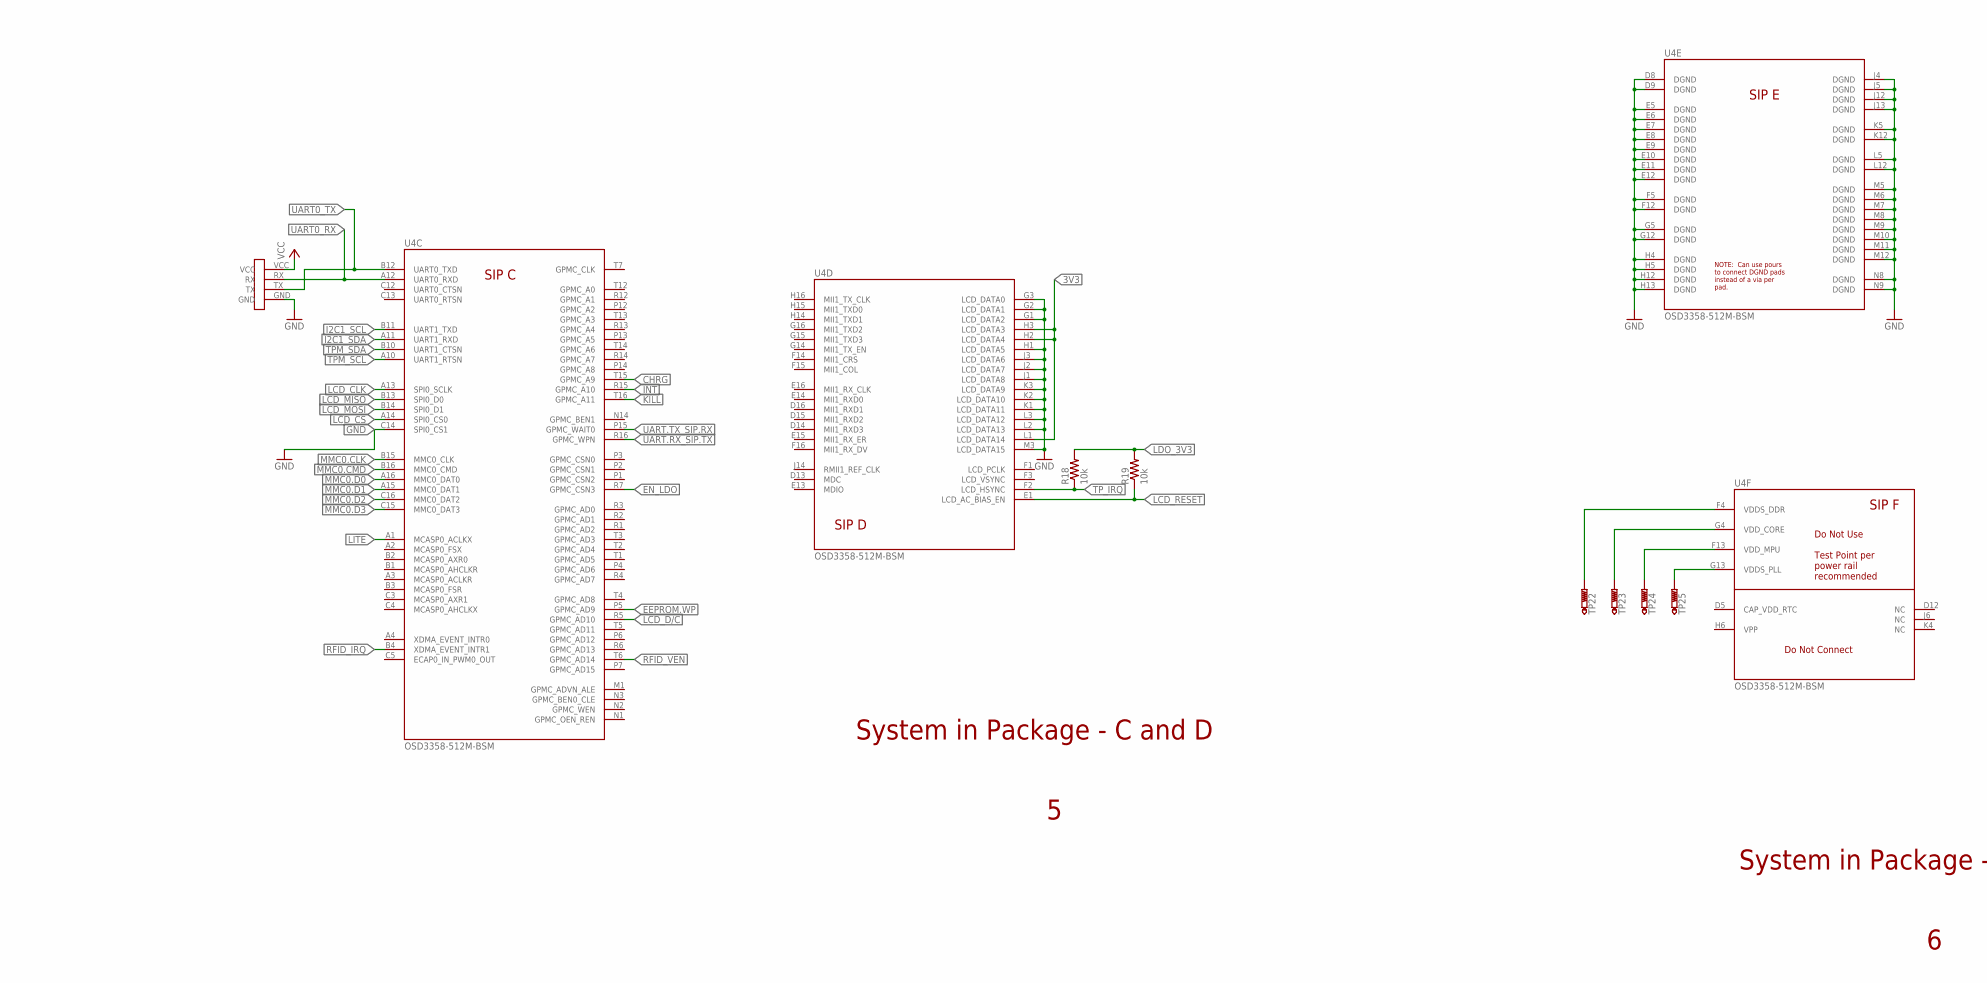
[picture p28: schematic Cypher.sch, part in row 1, column 3]

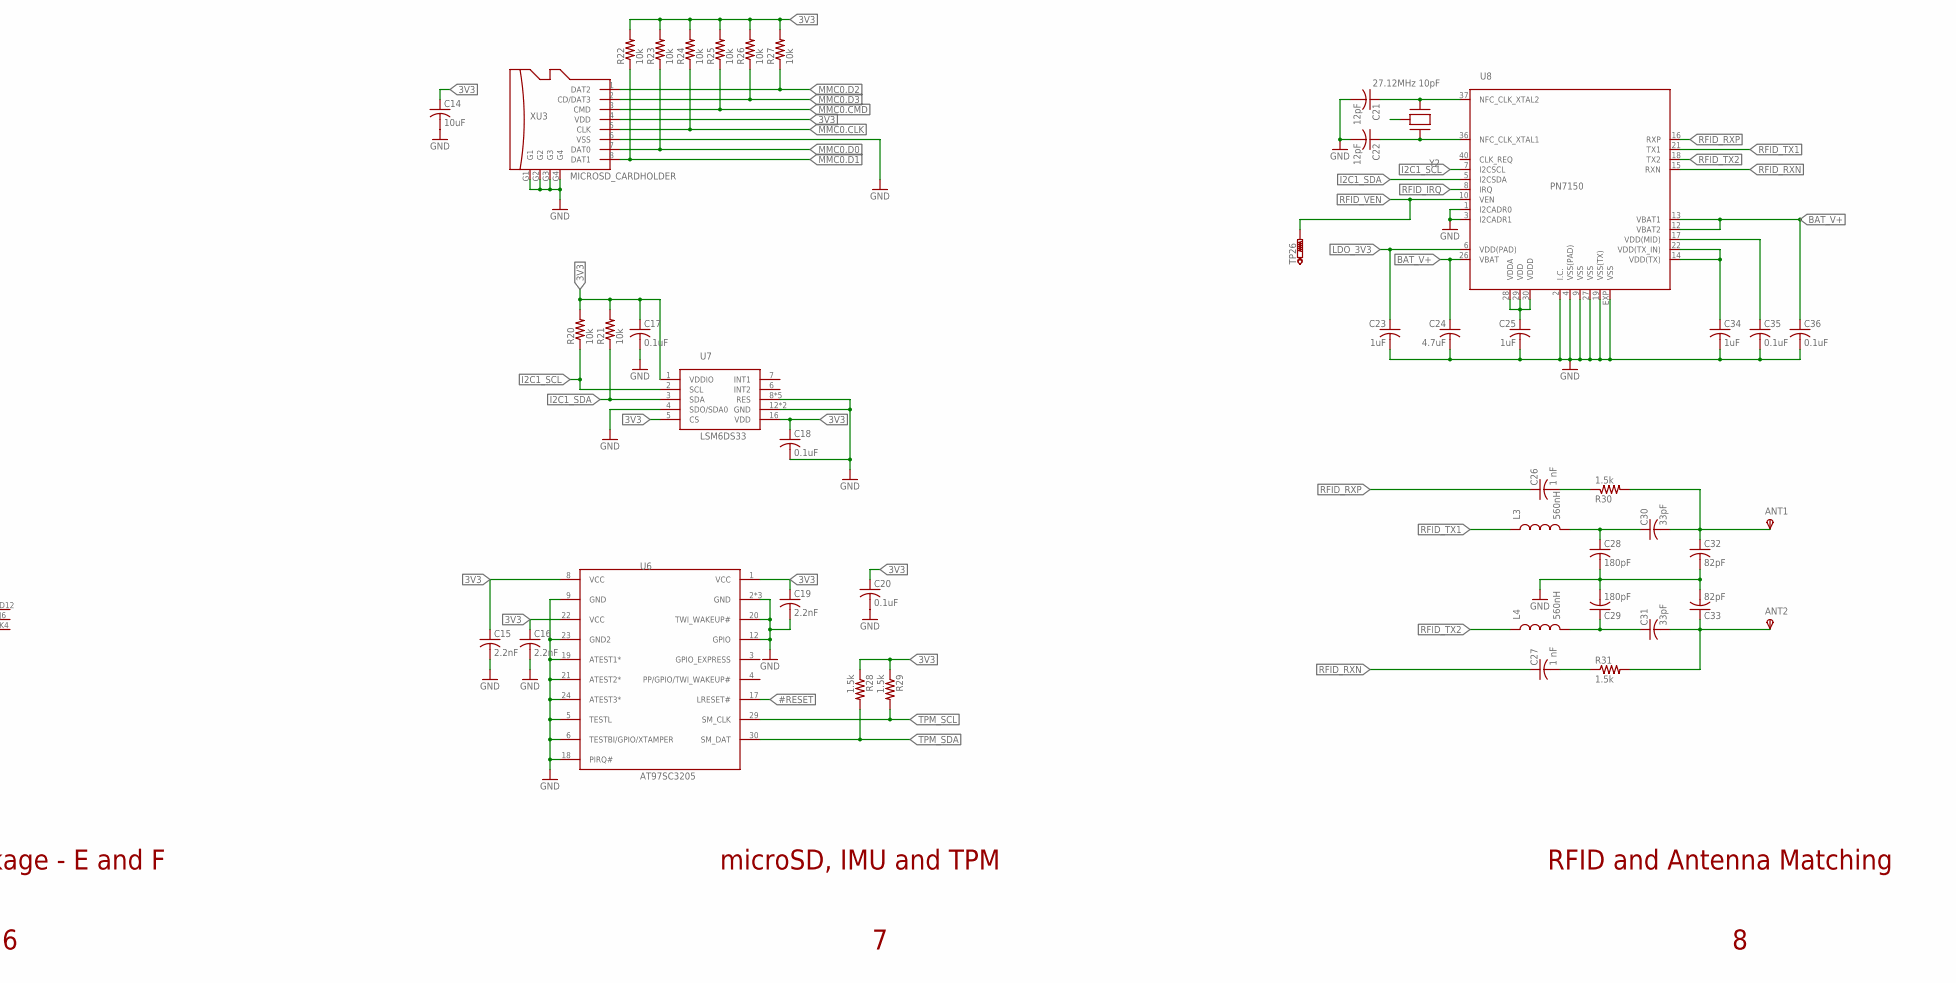
[picture p29: schematic Cypher.sch, part in row 1, column 4]

Parts:
ANT1, ANT2: TPSB2,54; B2,54
C1: 0.15 uF; C0402
C2: 47uF; C0805
C3, C23, C25, C34: 1uF; C0201
C4, C6, C7, C14: 10uF; C0402
C5: 120pF; C0201
C8: 10nF; C0201
C9, C10, C13, C17, C18, C20, C35, C36: 0.1uF; C0201
C11, C12, C21, C22: 12pF; C0201
C15, C16, C19: 2.2nF; C0201
C24: 4.7uF; C0603
C26, C27: 1 nF; C0603
C28, C29: 180pF; C0201
C30, C31: 33pF; C0201
C32, C33: 82pF; C0201
D1: Green; LED-0603
J1: MicroAB; MICRO-USB-AB-SMD
J2: 3.7V; SH_CONNECTOR
L1: 4.7uH; L2520
L2: 2.2uH; L2520
L3, L4: 560nH; C0402
Q1: MMBT2222; 3-XFDFN
R1: 806k; R0201
R2: 174k; R0201
R3: 1M; R0201
R4, R5, R9, R17, R18, R19, R20, R21, R22, R23, R24, R25, R26, R27: 10k; R0201
R6, R14: 160k; R0201
R7, R12: 240k; R0201
R8: 160; R0402
R10: 1k; R0201
R11: 750k; R0201
R13: 845k; R0201
R15: 590k; R0201
R16: 412k; R0201
R28, R29: 1.5k; R0201
R30, R31: 1.5k; R0402
RN1: 1k; EXBV4V
RN2: 10; EXBN8V
S1: EVQ-P7JO1P; EVQ-P7J01P
TP1, TP2, TP3, TP4, TP5, TP6, TP7, TP8, TP9, TP10, TP11, TP12, TP13, TP14, TP15, TP16, TP17, TP18, TP19, TP20, TP22, TP23, TP24, TP25, TP26: PTR1B1,27; B1,27
TP21: UARTPINS
U1: LTC2954-1-DFN; DFN8-3MMX2MM
U2: LTC3558; QFN20-3MM
U3: FT232RQ; QFN32; MPN FT232RQ-REEL
U4: OSD3358-512M-BSM; OSD335X-BGA-256; MPN BB-POCKET
U5: SN74LVC1G07DSFR; SON35P100X100X40-6N
U6: AT97SC3205; QFN32-4MM
U7: LSM6DS33; LGA-16; MPN LSM6DS33TR
U8: PN7150; HVQFN40
XU1: CAPTOUCHSCREEN_6PINFPC10PIN; DF37B-10DM-0.4V
XU2: ILI9388_50PIN_SOCKET; FPC/FFC_50PIN_0.5MMPITCH
XU3: MICROSD_CARDHOLDER; HINGED_LID_MICROSD
Y1: 24MHz 9pF; 4-SMD
Y2: 27.12MHz 10pF; XRCGB

Connections:
3V3: C14.1, C15.1, C16.1, C17.1, C18.1, C19.1, C20.1, R17.2, R20.2, R21.2, R22.2, R23.2, R24.2, R25.2, R26.2, R27.2, R28.1, R29.1, TP16.TP, U4.F6 (SYS_VDD1_3P3V), U4.F7 (SYS_VDD1_3P3V), U4.G6 (SYS_VDD1_3P3V), U4.G7 (SYS_VDD1_3P3V), U4.H2 (LCD_DATA4), U4.H3 (LCD_DATA3), U4.L1 (LCD_DATA14), U6.1 (VCC), U6.8 (VCC), U6.22 (VCC), U7.1 (VDDIO), U7.5 (CS), U7.16 (VDD), XU3.4 (VDD)
#RESET: R17.1, TP14.TP, U4.R11 (WARMRSTN), U5.4 (Y), U6.17 (LRESET#)
AIN.VREF+: C13.1, U4.A7 (SYS_ADC_1P8V), U4.B7 (VREFP)
AIN.VREF-: C13.2, U4.A9 (AGND_ADC), U4.B9 (VREFN)
ANT_1: ANT1.TP, C30.2, C32.1, R30.2
ANT_2: ANT2.TP, C31.2, C33.1, R31.2
BAT_V+: C4.1, C24.1, C36.1, J2.1 (V+), R1.2, R3.2, R4.2, R15.2, TP5.TP, U1.4 (VIN), U2.2 (BAT), U2.7 (PVIN1), U2.8 (PVIN2), U8.12 (VBAT2), U8.13 (VBAT1), U8.26 (VBAT)
CHRG: R6.1, R7.2, U4.T15 (GPMC_A9)
CHRG+: D1.C, R6.2, U2.19 (CHRG)
EEPROM.WP: TP12.TP, U4.M2 (EEPROM_WP), U4.P5 (GPMC_AD9)
EMCF_ANTM1: C28.1, C30.1, L3.2
EMCF_ANTM2: C29.1, C31.1, L4.2
EN: R3.1, TP3.TP, U1.7 (EN), U2.15 (EN2)
EN_LDO: R9.1, TP4.TP, U2.5 (EN1), U4.R7 (GPMC_CSN3)
FB1: R11.1, R12.2, U2.4 (FB1)
FB2: C5.1, R13.1, R14.2, U2.13 (FB2)
GND: C1.2, C2.2, C3.2, C4.2, C6.2, C7.2, C8.2, C9.2, C10.2, C11.2, C12.2, C14.2, C15.2, C16.2, C17.2, C18.2, C19.2, C20.2, C21.2, C22.2, C23.2, C24.2, C25.2, C28.2, C29.2, C32.2, C33.2, C34.2, C35.2, C36.2, J1.5 (GND), J1.PAD1 (GND), J1.PAD2 (GND), J1.PAD3 (GND), J1.PAD4 (GND), J1.PAD5 (GND), J1.PAD6 (GND), J2.2 (V-), Q1.2 (E), R2.1, R7.1, R9.2, R10.1, R12.1, R14.1, R16.1, RN1.3 (2), S1.2, S1.2' (2), TP21.GND, U1.1 (GND), U1.EXP (GND), U2.1 (GND), U2.12 (SUSP), U2.17 (NTC), U2.PAD (EXPOSED_PAD), U3.4 (GND), U3.17 (GND), U3.20 (GND), U3.24 (GND), U3.26 (TEST), U4.C14 (SPI0_CS1), U4.D8 (DGND), U4.D9 (DGND), U4.E5 (DGND), U4.E6 (DGND), U4.E7 (DGND), U4.E8 (DGND), U4.E9 (DGND), U4.E10 (DGND), U4.E11 (DGND), U4.E12 (DGND), U4.F5 (DGND), U4.F12 (DGND), U4.G1 (LCD_DATA2), U4.G2 (LCD_DATA1), U4.G3 (LCD_DATA0), U4.G5 (DGND), U4.G12 (DGND), U4.H1 (LCD_DATA5), U4.H4 (DGND), U4.H5 (DGND), U4.H12 (DGND), U4.H13 (DGND), U4.J1 (LCD_DATA8), U4.J2 (LCD_DATA7), U4.J3 (LCD_DATA6), U4.J4 (DGND), U4.J5 (DGND), U4.J12 (DGND), U4.J13 (DGND), U4.K1 (LCD_DATA11), U4.K2 (LCD_DATA10), U4.K3 (LCD_DATA9), U4.K5 (DGND), U4.K12 (DGND), U4.L2 (LCD_DATA13), U4.L3 (LCD_DATA12), U4.L5 (DGND), U4.L12 (DGND), U4.M3 (LCD_DATA15), U4.M5 (DGND), U4.M6 (DGND), U4.M7 (DGND), U4.M8 (DGND), U4.M9 (DGND), U4.M10 (DGND), U4.M11 (DGND), U4.M12 (DGND), U4.M16 (RTC_KALDO_ENN), U4.N8 (DGND), U4.N9 (DGND), U4.N15 (OSC0_GND), U5.3 (GND), U6.2 (GND), U6.5 (TESTL), U6.6 (TESTBI/GPIO/XTAMPER), U6.9 (GND), U6.12 (GPIO), U6.18 (PIRQ#), U6.19 (ATEST1*), U6.20 (TWI_WAKEUP#), U6.21 (ATEST2*), U6.23 (GND2), U6.24 (ATEST3*), U6.32 (GND), U6.EXP (GND), U7.4 (SDO/SDA0), U7.8 (RES), U7.9 (RES), U7.10 (RES), U7.11 (RES), U7.12 (GND), U7.13 (GND), U7.15 (RES), U8.1 (I2CADR0), U8.2 (I.C.), U8.3 (I2CADR1), U8.4 (VSS(PAD)), U8.9 (VSS), U8.19 (VSS(TX)), U8.27 (VSS), U8.EXP (VSS), XU1.5 (GND), XU1.6 (GND), XU1.7 (GND), XU1.8 (GND), XU2.11 (VSYNC), XU2.12 (HSYNC), XU2.14 (DE), XU2.15 (DB17), XU2.16 (DB16), XU2.17 (DB15), XU2.18 (DB14), XU2.19 (DB13), XU2.20 (DB12), XU2.21 (DB11), XU2.22 (DB10), XU2.23 (DB9), XU2.24 (DB8), XU2.25 (DB7), XU2.26 (DB6), XU2.27 (DB5), XU2.28 (DB4), XU2.29 (DB3), XU2.30 (DB2), XU2.31 (DB1), XU2.32 (DB0), XU2.35 (#RD), XU2.43 (GND), XU2.48 (GND), XU2.49 (GND), XU2.50 (GND), XU3.6 (VSS), XU3.G1, XU3.G2, XU3.G3, XU3.G4, Y1.2 (GND), Y1.4 (GND)
HPWR: R5.1, U2.16 (HPWR)
I2C0_SCL: U4.C10 (I2C0_SCL), U4.D10 (PMIC_SCL)
I2C0_SDA: U4.C11 (I2C0_SDA), U4.D11 (PMIC_SDA)
I2C1_SCL: R20.1, U4.B11 (UART1_TXD), U7.2 (SCL), U8.7 (I2CSCL), XU1.4 (SCL)
I2C1_SDA: R21.1, U4.A11 (UART1_RXD), U7.3 (SDA), U8.5 (I2CSDA), XU1.3 (SDA)
INT: U1.8 (INT), U4.R15 (GPMC_A10)
KILL: R1.1, R2.2, TP1.TP, U1.5 (KILL), U4.T16 (GPMC_A11)
LCD_CLK: U4.A13 (SPI0_SCLK), XU2.36 (#WR)
LCD_CS: U4.A14 (SPI0_CS0), XU2.38 (#CS)
LCD_D/C: U4.R5 (GPMC_AD10), XU2.37 (#D/C)
LCD_MISO: U4.B13 (SPI0_D0), XU2.33 (SDO)
LCD_MOSI: U4.B14 (SPI0_D1), XU2.34 (SDI)
LCD_RESET: R19.1, U4.E1 (LCD_AC_BIAS_EN), XU1.2 (RESET), XU2.10 (RESET)
LDO_3V3: C6.1, C23.1, L1.2, R11.2, R18.2, R19.2, RN1.1, RN1.2 (1), RN2.1, RN2.2 (1), RN2.3 (1), RN2.4 (1), TP6.TP, U8.6 (VDD(PAD)), XU1.9 (VDD), XU1.10 (VDD), XU2.6 (IM0), XU2.7 (IM1), XU2.8 (IM2), XU2.13 (DOTCLK), XU2.40 (IOVCC), XU2.41 (IOVCC), XU2.42 (VCI)
LDO_BOOSTER_MODE: R4.1, U2.3 (MODE)
LEDA@2: RN2.8 (2), XU2.2 (LEDA)
LEDA@3: RN2.7 (2), XU2.3 (LEDA)
LEDA@4: RN2.6 (2), XU2.4 (LEDA)
LEDA@5: RN2.5 (2), XU2.5 (LEDA)
LEDK: Q1.3 (C), XU2.1 (LEDK)
LED_A: D1.A, R8.1
LITE: Q1.1 (B), RN1.4 (2), U4.A1 (MCASP0_ACLKX)
MMC0.CLK: R24.1, U4.B15 (MMC0_CLK), XU3.5 (CLK)
MMC0.CMD: R25.1, U4.B16 (MMC0_CMD), XU3.3 (CMD)
MMC0.D0: R23.1, U4.A16 (MMC0_DAT0), XU3.7 (DAT0)
MMC0.D1: R22.1, U4.A15 (MMC0_DAT1), XU3.8 (DAT1)
MMC0.D2: R27.1, U4.C16 (MMC0_DAT2), XU3.1 (DAT2)
MMC0.D3: R26.1, U4.C15 (MMC0_DAT3), XU3.2 (CD/DAT3)
NC: Y2.2 (GND), Y2.4 (GND)
ON_T: C1.1, U1.2 (ONT)
PB: S1.1, S1.1' (1), U1.3 (PB)
PD_T: C2.1, U1.6 (PDT)
PMIC1: TP8.TP, U4.N10 (PMIC_POWER_EN), U4.N11 (PMIC_PWR_EN)
PMIC2: TP9.TP, U4.N4 (PMIC_LDO_PGOOD), U4.N5 (RTC_PWRONRSTN)
PMIC3: TP10.TP, U4.L4 (PMIC_NWAKEUP), U4.M4 (EXT_WAKEUP)
PMIC4: TP11.TP, U4.D4 (EXTINTN), U4.E4 (PMIC_NINT)
PMIC_PGOOD: TP13.TP, U4.N12 (PMIC_PGOOD), U4.P11 (PWRONRSTN), U5.2 (A)
PROG: R10.2, U2.18 (PROG)
RFID_IRQ: U4.B4 (XDMA_EVENT_INTR1), U8.8 (IRQ)
RFID_MISC_1: C26.2, R30.1
RFID_MISC_2: C27.2, R31.1
RFID_OSC_IN: C22.1, U8.36 (NFC_CLK_XTAL1), Y2.1 (OSC_IN)
RFID_OSC_OUT: C21.1, U8.37 (NFC_CLK_XTAL2), Y2.3 (OSC_OUT)
RFID_RXN: C27.1, U8.15 (RXN)
RFID_RXP: C26.1, U8.16 (RXP)
RFID_TX1: L3.1, U8.21 (TX1)
RFID_TX2: L4.1, U8.18 (TX2)
RFID_VEN: TP26.TP, U4.T6 (GPMC_AD14), U8.10 (VEN)
RTC_1P8: C10.1, TP18.TP, U4.K11 (SYS_RTC_1P8V), U4.L11 (SYS_RTC_1P8V), U5.6 (VCC)
SIP_OSC_IN: C11.1, U4.P16 (OSC0_IN), Y1.1 (OSC_IN)
SIP_OSC_OUT: C12.1, U4.N16 (OSC0_OUT), Y1.3 (OSC_OUT)
SW1: L1.1, U2.6 (SW1)
SWAB2: L2.1, U2.9 (SWAB2)
SWCD2: L2.2, U2.10 (SWCD2)
SYS_VDD2_3P3V: TP17.TP, U4.F11 (SYS_VDD2_3P3V), U4.G11 (SYS_VDD2_3P3V)
SYS_VDD3_3P3V: TP19.TP, U4.F8 (SYS_VDD3_3P3V), U4.F9 (VDDSHV4), U4.G8 (SYS_VDD3_3P3V), U4.G9 (VDDSHV5), U4.H7 (SYS_VDD3_3P3V), U4.H8 (SYS_VDD3_3P3V), U4.H9 (VDDSHV6), U4.J7 (SYS_VDD3_3P3V), U4.J8 (SYS_VDD3_3P3V), U4.J9 (VDDSHV1), U4.K8 (SYS_VDD3_3P3V), U4.K9 (VDDSHV2), U4.L8 (SYS_VDD3_3P3V), U4.L9 (VDDSHV3)
SYS_VDD_1P8V: TP20.TP, U4.F10 (SYS_VDD_1P8V), U4.G10 (SYS_VDD_1P8V), U4.H10 (SYS_VDD_1P8V), U4.H11 (SYS_VDD_1P8V), U4.J10 (SYS_VDD_1P8V), U4.J11 (SYS_VDD_1P8V), U4.K10 (SYS_VDD_1P8V), U4.L10 (SYS_VDD_1P8V)
SYS_VOUT: TP15.TP, U4.K6 (SYS_VOUT), U4.K7 (SYS_VOUT), U4.L6 (SYS_VOUT), U4.L7 (SYS_VOUT)
TPM_SCL: R29.2, U4.A10 (UART1_RTSN), U6.29 (SM_CLK)
TPM_SDA: R28.2, U4.B10 (UART1_CTSN), U6.30 (SM_DAT)
TP_IRQ: R18.1, U4.F2 (LCD_HSYNC), XU1.1 (INT)
UART0_RX: TP21.RX, U4.A12 (UART0_RXD)
UART0_TX: TP21.TX, U4.B12 (UART0_TXD)
UART.RX_SIP.TX: U3.2 (RXD), U4.R16 (GPMC_WPN)
UART.TX_SIP.RX: U3.30 (TXD), U4.P15 (GPMC_WAIT0)
UART_3V3: C9.1, U3.1 (VCCIO), U3.16 (3V3OUT)
USB+: J1.3 (D+), U3.14 (USBDP)
USB-: J1.2 (D-), U3.15 (USBDM)
VC2: C5.2, U2.14 (VC2)
VCC: C7.1, C8.1, R13.2, TP7.TP, TP21.VCC, U2.11 (VOUT2), U3.18 (!RESET), U3.19 (VCC), U4.P9 (VIN_USB), U4.R9 (VIN_USB), U4.T9 (VIN_USB)
VDD: C25.1, U8.28 (VDDA), U8.29 (VDD), U8.30 (VDDD)
VDD(MID): C35.1, U8.17 (VDD(MID))
VDD(TX): C34.1, U8.14 (VDD(TX)), U8.22 (VDD(TX_IN))
VDDS_DDR: TP22.TP, U4.F4 (VDDS_DDR)
VDDS_PLL: TP25.TP, U4.G13 (VDDS_PLL)
VDD_CORE: TP23.TP, U4.G4 (VDD_CORE)
VDD_MPU: TP24.TP, U4.F13 (VDD_MPU)
VIN_AC: U4.P10 (VIN_AC), U4.R10 (VIN_AC), U4.T10 (VIN_AC)
VIN_BAT: U4.N7 (PMIC_BAT_SENSE), U4.P8 (VIN_BAT), U4.R8 (VIN_BAT), U4.T8 (VIN_BAT)
VIN_USB: C3.1, J1.1 (VCC), R5.2, R8.2, TP2.TP, U2.20 (VCC)
V_BAT_REF: R15.1, R16.2, U4.C6 (AIN3)

Notes on the sheet:
Power Management
LCD, Touchscreen and UART to USB
System in Package - A
System in Package - B
System in Package - C and D
System in Package - E and F
microSD, IMU and TPM
RFID and Antenna Matching

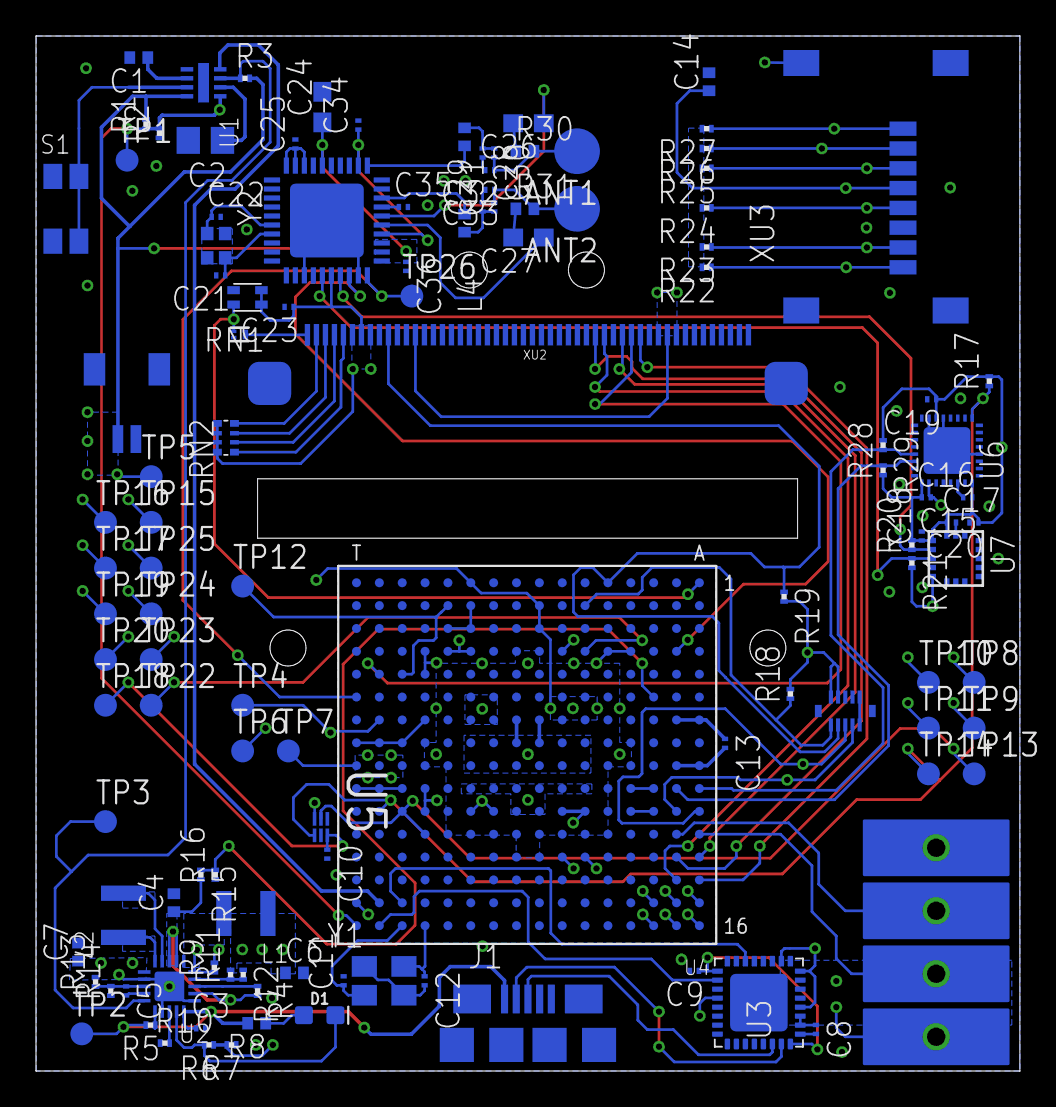
[picture p30: board Cypher.brd from below]

Board: 4 copper layers, 54.7 x 57.5 mm, 119 parts (119 on the bottom side), 98 nets.
