intelsath/Cypher/Hardware/Eagle/Cypher - V0.4.brd

## EAGLE design Hardware/Eagle/Cypher - V0.4.brd (2020-03-15)

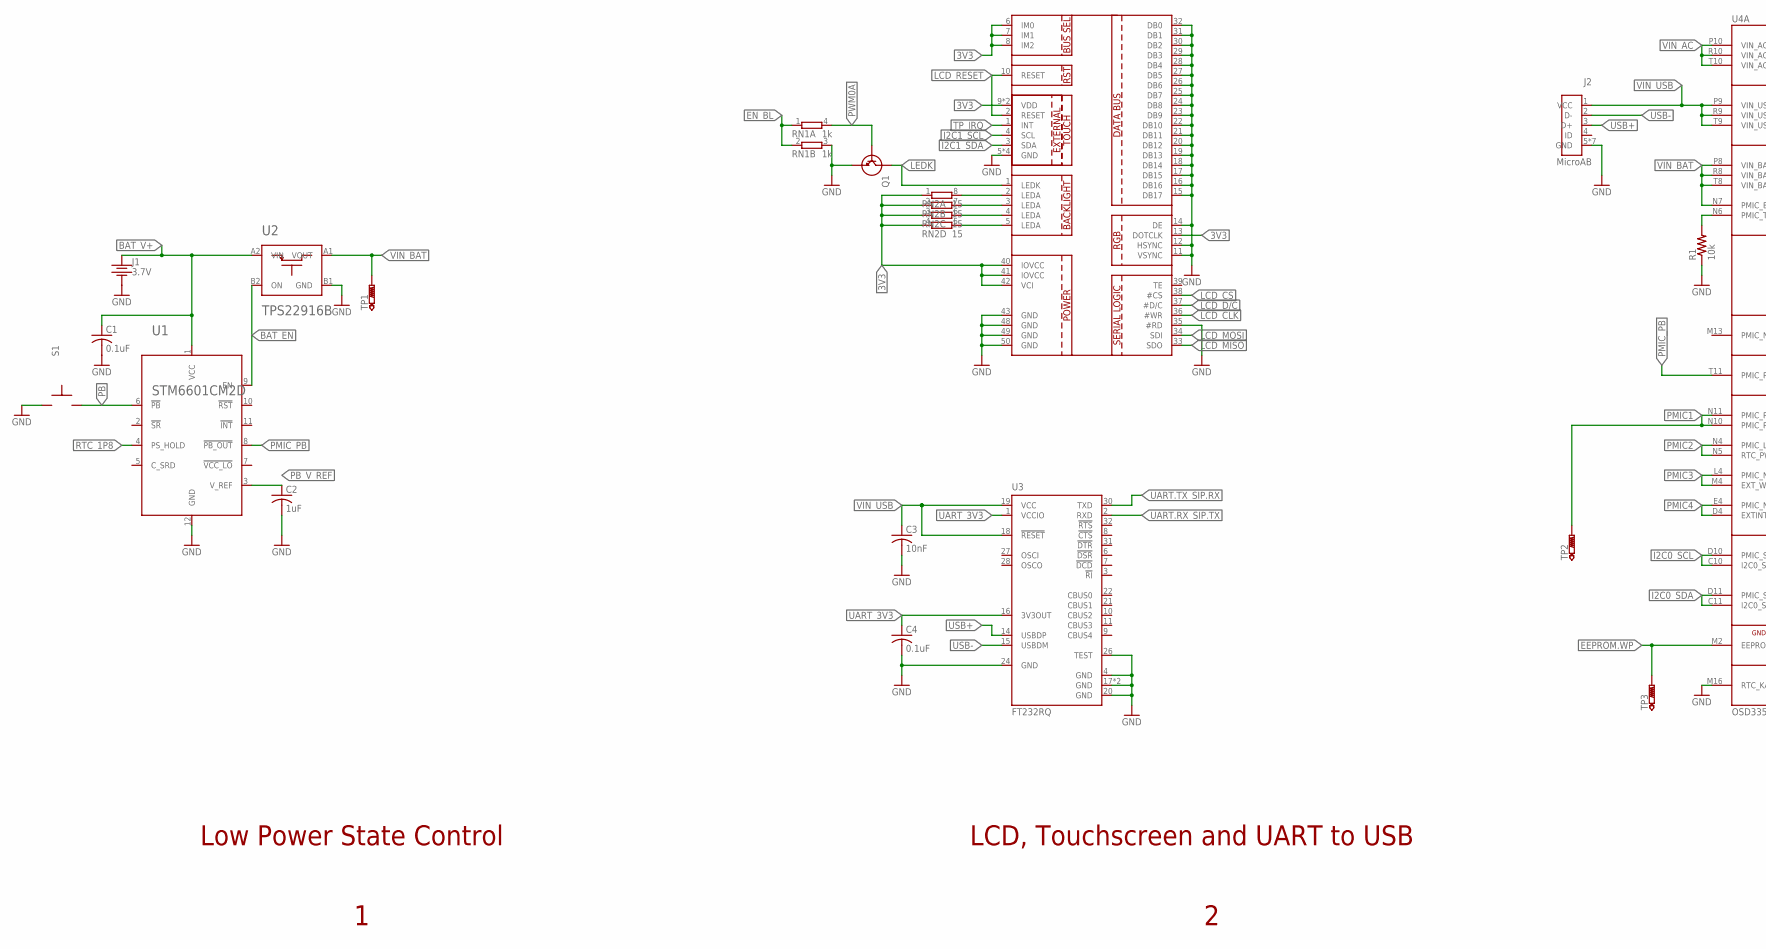
[picture p31: schematic Cypher - V0.4.sch, part in row 1, column 1]

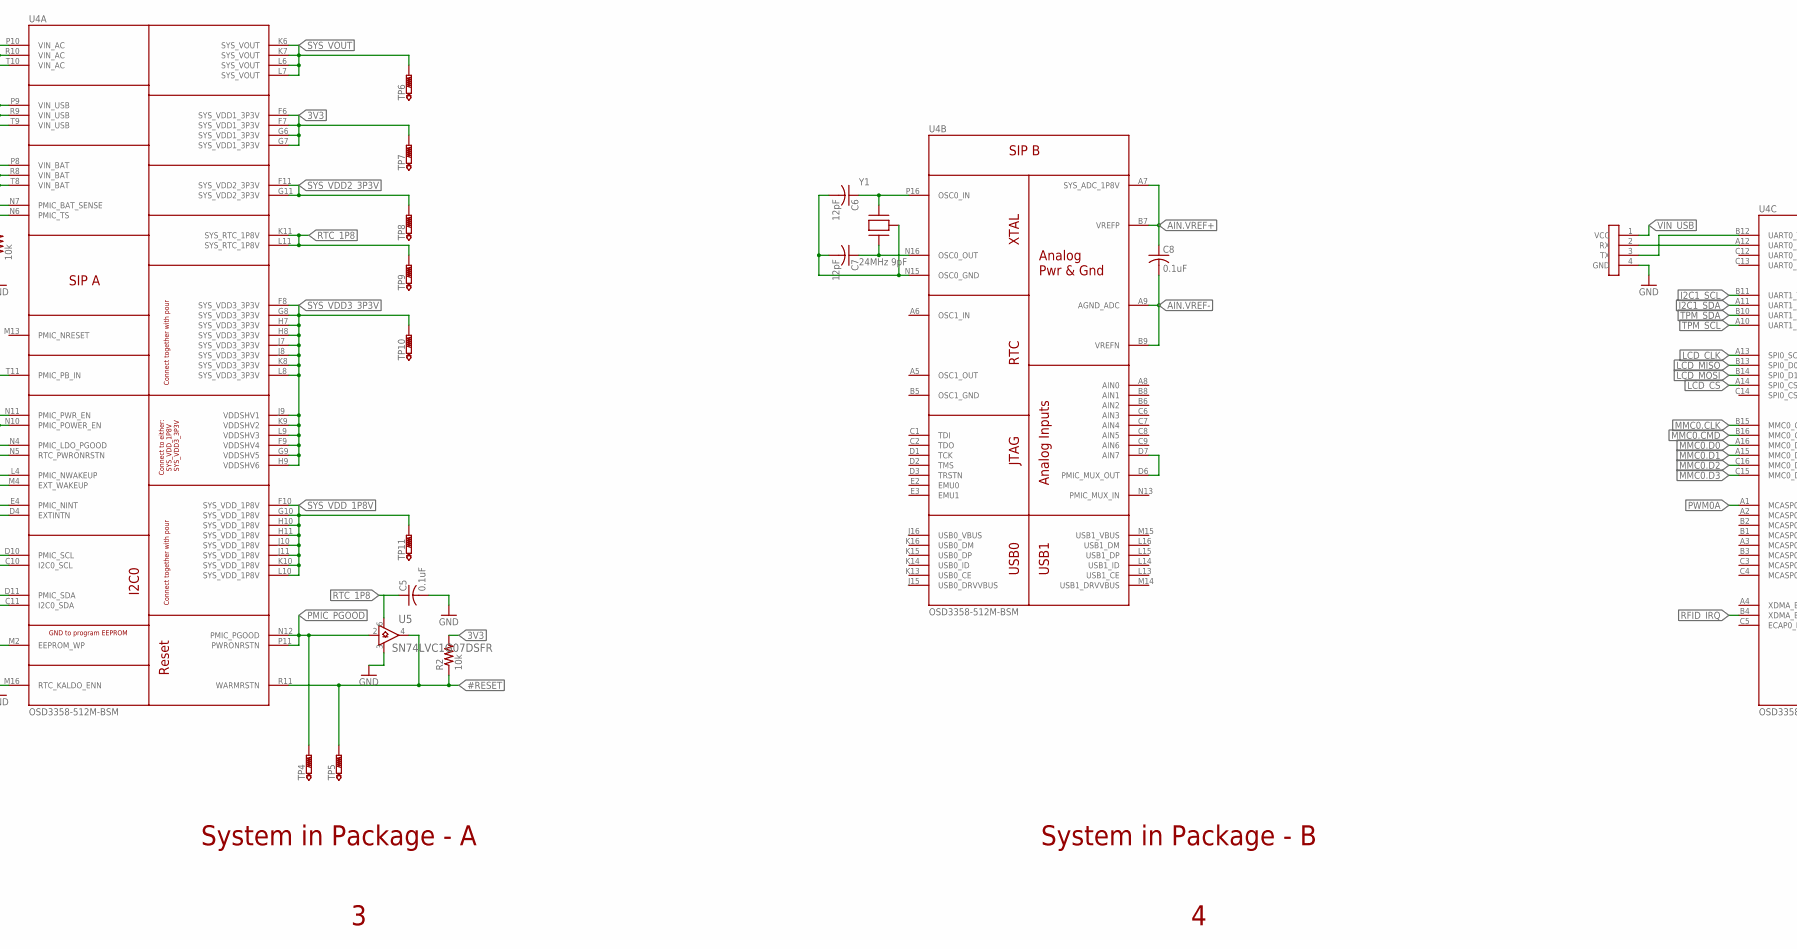
[picture p32: schematic Cypher - V0.4.sch, part in row 1, column 2]

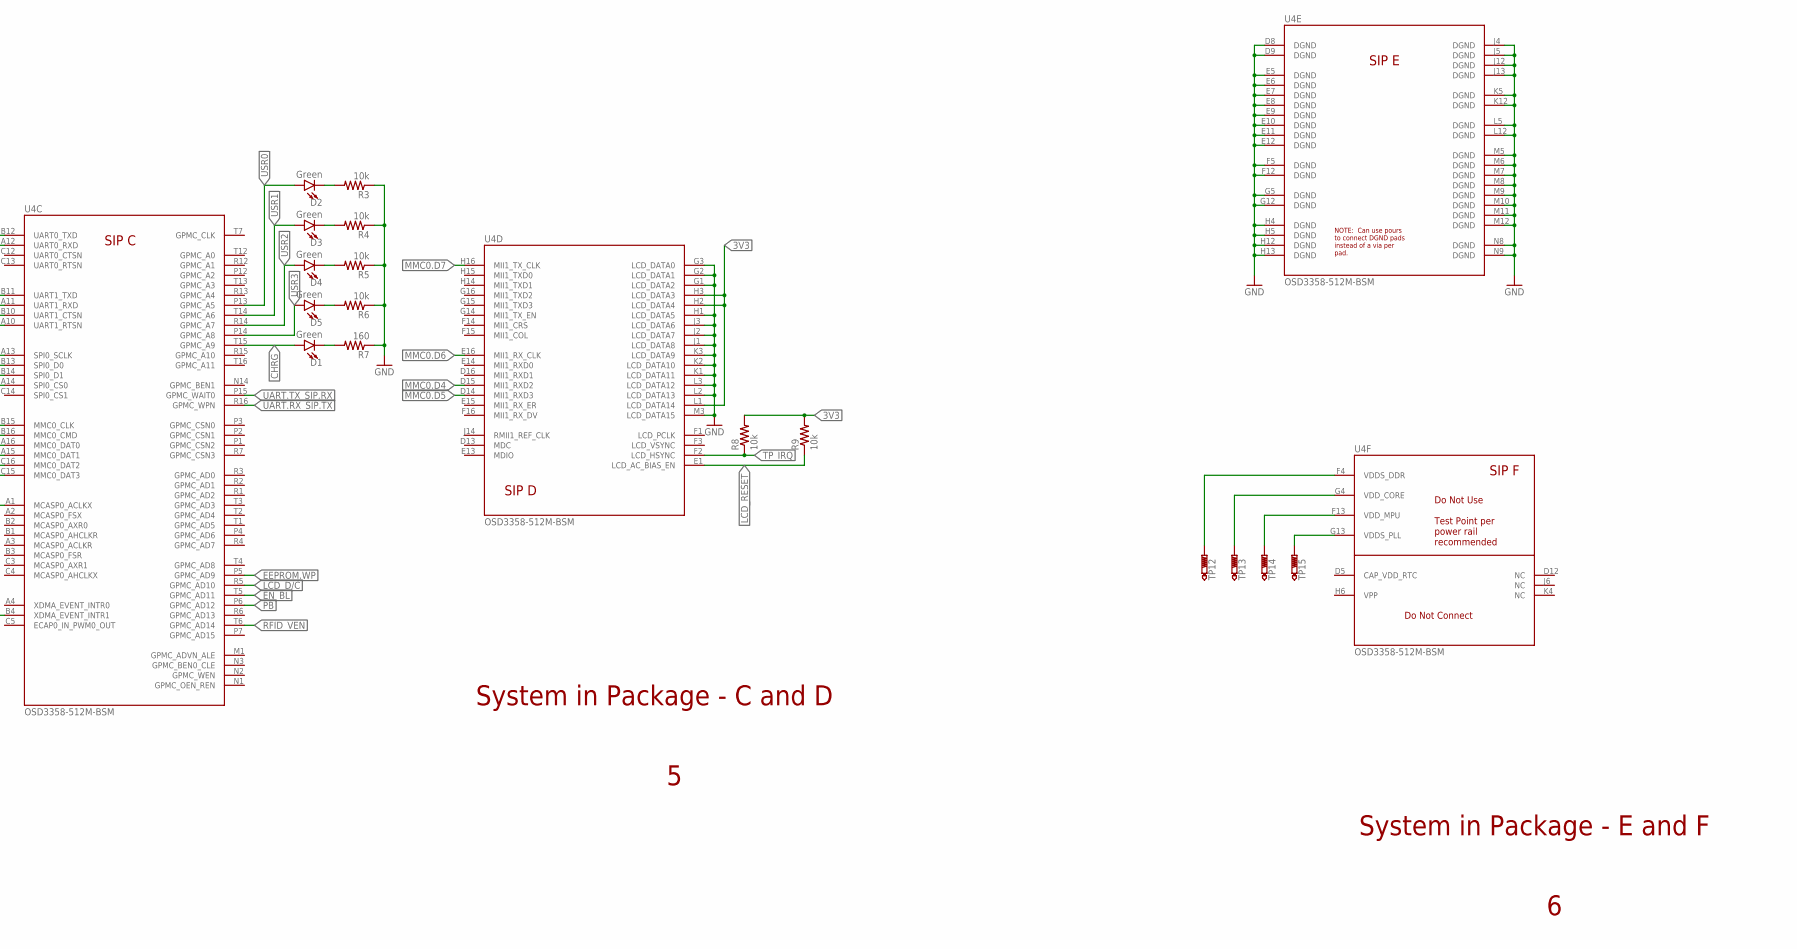
[picture p33: schematic Cypher - V0.4.sch, part in row 1, column 3]

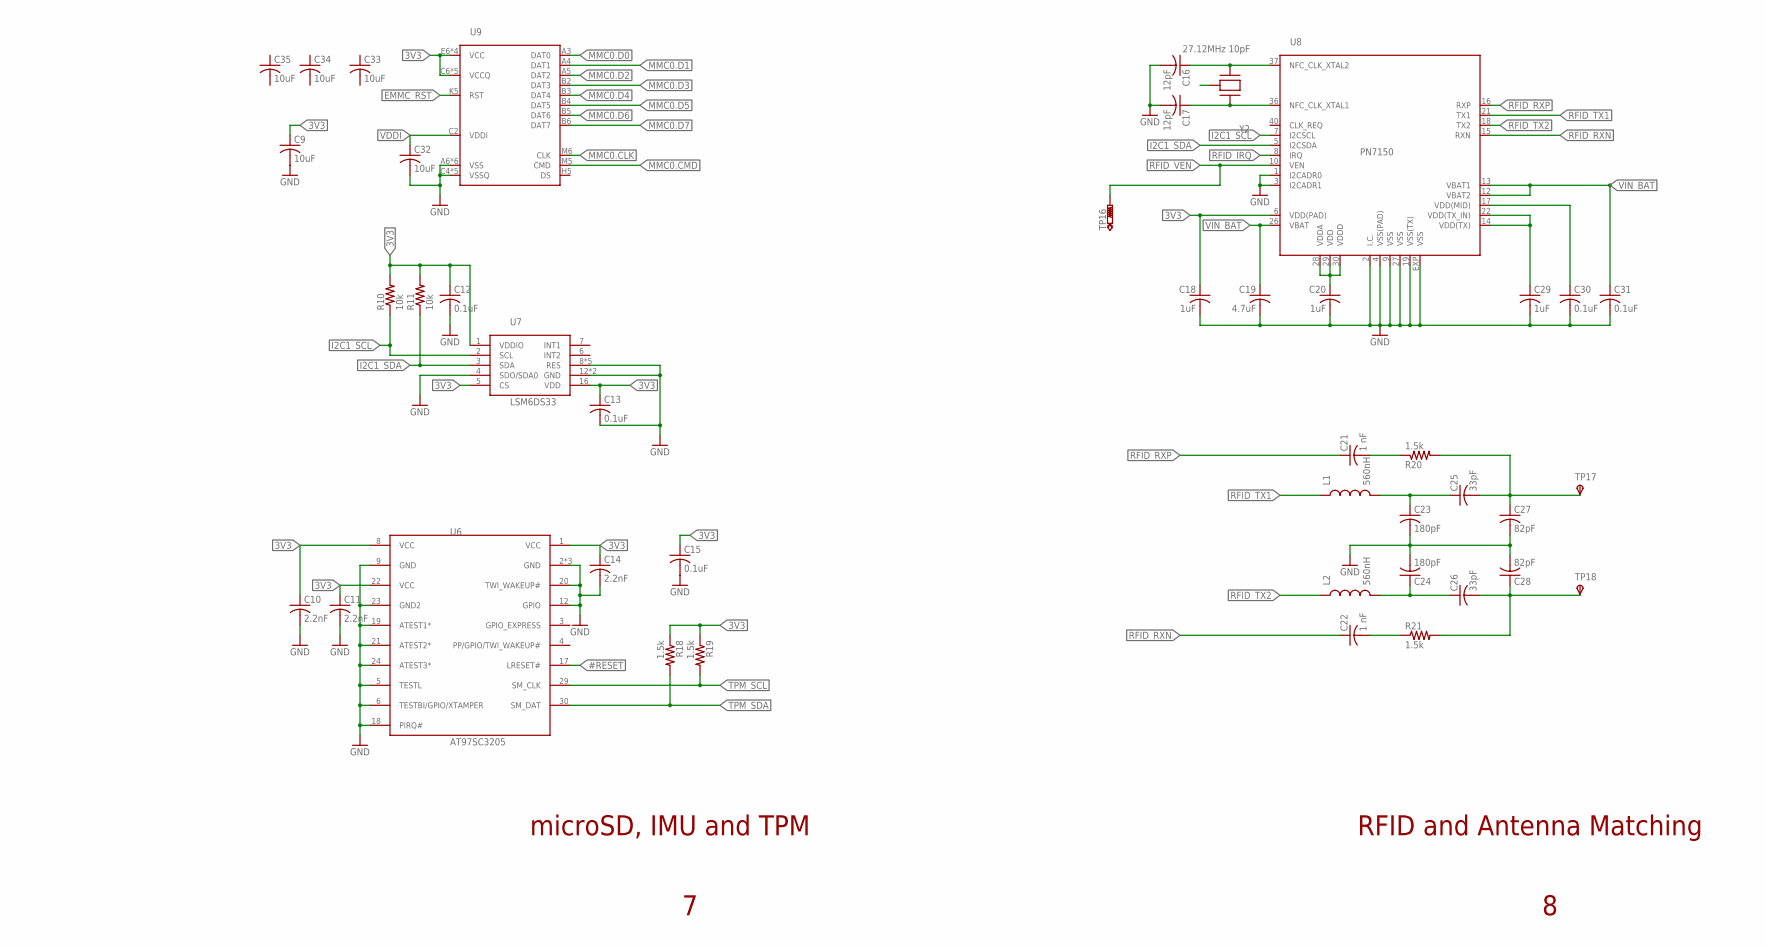
[picture p34: schematic Cypher - V0.4.sch, part in row 1, column 4]

Parts:
C1, C4, C5, C8, C12, C13, C15, C30, C31: 0.1uF; C0402
C2, C18, C20, C29: 1uF; C0402
C3: 10nF; C0402
C6, C7, C16, C17: 12pF; C0402
C9, C32, C33, C34, C35: 10uF; C0402
C10, C11, C14: 2.2nF; C0402
C19: 4.7uF; C0402
C21, C22: 1 nF; C0603
C23, C24: 180pF; C0402
C25, C26: 33pF; C0402
C27, C28: 82pF; C0402
D1, D2, D3, D4, D5: Green; LED-0603
J1: 3.7V; SH_CONNECTOR
J2: MicroAB; MICRO-USB-AB-SMD
J3: UARTPINSSH; SM04B-SRSS-TB
L1, L2: 560nH; C0402
Q1: MMBT2222ASOT23; SOT-23-3
R1, R2, R3, R4, R5, R6, R8, R9, R10, R11: 10k; R0402
R7: 160; R0402
R18, R19, R20, R21: 1.5k; R0402
RN1: 1k; EXBV4V
RN2: 15; EXBN8V
S1: PUSHBUTTON1.2; EVQ-PUK
TP1, TP2, TP3, TP4, TP5, TP6, TP7, TP8, TP9, TP10, TP11, TP12, TP13, TP14, TP15, TP16: PTR1B1,27; B1,27
TP17, TP18: TPSB2,54; B2,54
U1: STM6601CM2D; TDFN12
U2: TPS22916B; WSON-4PIN
U3: FT232RQ; QFN32; MPN FT232RQ-REEL
U4: OSD3358-512M-BSM; OSD335X-BGA-256; MPN BB-POCKET
U5: SN74LVC1G07DSFR; SON35P100X100X40-6N
U6: AT97SC3205; QFN32-4MM
U7: LSM6DS33; LGA-16; MPN LSM6DS33TR
U8: PN7150; HVQFN40
U9: EMMC_EM-20; 153-LFBGA
XU1: CAPTOUCHSCREEN_6PINFPC10PIN; DF37NB-10DS-0.4V
XU2: ILI9388_50PIN_SOCKET; FPC/FFC_50PIN_0.5MMPITCH
Y1: 24MHz 9pF; 4-SMD
Y2: 27.12MHz 10pF; XRCGB

Connections:
3V3: C9.1, C10.1, C11.1, C12.1, C13.1, C14.1, C15.1, C18.1, R2.2, R8.2, R9.2, R10.2, R11.2, R18.1, R19.1, RN2.1, RN2.2 (1), RN2.3 (1), RN2.4 (1), TP7.TP, U4.F6 (SYS_VDD1_3P3V), U4.F7 (SYS_VDD1_3P3V), U4.G6 (SYS_VDD1_3P3V), U4.G7 (SYS_VDD1_3P3V), U4.H2 (LCD_DATA4), U4.H3 (LCD_DATA3), U4.L1 (LCD_DATA14), U6.1 (VCC), U6.8 (VCC), U6.22 (VCC), U7.1 (VDDIO), U7.5 (CS), U7.16 (VDD), U8.6 (VDD(PAD)), U9.C6 (VCCQ), U9.E6 (VCC), U9.F5 (VCC), U9.J10 (VCC), U9.K9 (VCC), U9.M4 (VCCQ), U9.N4 (VCCQ), U9.P3 (VCCQ), U9.P5 (VCCQ), XU1.9 (VDD), XU1.10 (VDD), XU2.6 (IM0), XU2.7 (IM1), XU2.8 (IM2), XU2.13 (DOTCLK), XU2.40 (IOVCC), XU2.41 (IOVCC), XU2.42 (VCI)
#RESET: R2.1, TP5.TP, U4.R11 (WARMRSTN), U5.4 (Y), U6.17 (LRESET#)
AIN.VREF+: C8.1, U4.A7 (SYS_ADC_1P8V), U4.B7 (VREFP)
AIN.VREF-: C8.2, U4.A9 (AGND_ADC), U4.B9 (VREFN)
ANT_1: C25.2, C27.1, R20.2, TP17.TP
ANT_2: C26.2, C28.1, R21.2, TP18.TP
BAT_EN: U1.9 (EN), U2.B2 (ON)
BAT_V+: C1.1, J1.2 (V+), U1.1 (VCC), U2.A2 (VIN)
CHRG: D1.A, U4.T15 (GPMC_A9)
D2_CAT: D2.C, R3.2
D2_CAT1: D1.C, R7.2
D3_CAT: D3.C, R4.2
D4_CAT: D4.C, R5.2
D5_CAT: D5.C, R6.2
EEPROM.WP: TP3.TP, U4.M2 (EEPROM_WP), U4.P5 (GPMC_AD9)
EMCF_ANTM1: C23.1, C25.1, L1.2
EMCF_ANTM2: C24.1, C26.1, L2.2
EMMC_RST: U9.K5 (RST)
EN_BL: RN1.1, RN1.2 (1), U4.T5 (GPMC_AD11)
GND: C1.2, C2.2, C3.2, C4.2, C5.2, C9.2, C10.2, C11.2, C12.2, C13.2, C14.2, C15.2, C16.2, C17.2, C18.2, C19.2, C20.2, C23.2, C24.2, C27.2, C28.2, C29.2, C30.2, C31.2, C32.2, J1.1 (V-), J2.5 (GND), J2.PAD1 (GND), J2.PAD2 (GND), J2.PAD3 (GND), J2.PAD4 (GND), J2.PAD5 (GND), J2.PAD6 (GND), J3.4 (GND), Q1.E, R1.1, R3.1, R4.1, R5.1, R6.1, R7.1, RN1.3 (2), S1.2, S1.4 (2), U1.12 (GND), U2.B1 (GND), U3.4 (GND), U3.17 (GND), U3.20 (GND), U3.24 (GND), U3.26 (TEST), U3.EXP (GND), U4.D8 (DGND), U4.D9 (DGND), U4.E5 (DGND), U4.E6 (DGND), U4.E7 (DGND), U4.E8 (DGND), U4.E9 (DGND), U4.E10 (DGND), U4.E11 (DGND), U4.E12 (DGND), U4.F5 (DGND), U4.F12 (DGND), U4.G1 (LCD_DATA2), U4.G2 (LCD_DATA1), U4.G3 (LCD_DATA0), U4.G5 (DGND), U4.G12 (DGND), U4.H1 (LCD_DATA5), U4.H4 (DGND), U4.H5 (DGND), U4.H12 (DGND), U4.H13 (DGND), U4.J1 (LCD_DATA8), U4.J2 (LCD_DATA7), U4.J3 (LCD_DATA6), U4.J4 (DGND), U4.J5 (DGND), U4.J12 (DGND), U4.J13 (DGND), U4.K1 (LCD_DATA11), U4.K2 (LCD_DATA10), U4.K3 (LCD_DATA9), U4.K5 (DGND), U4.K12 (DGND), U4.L2 (LCD_DATA13), U4.L3 (LCD_DATA12), U4.L5 (DGND), U4.L12 (DGND), U4.M3 (LCD_DATA15), U4.M5 (DGND), U4.M6 (DGND), U4.M7 (DGND), U4.M8 (DGND), U4.M9 (DGND), U4.M10 (DGND), U4.M11 (DGND), U4.M12 (DGND), U4.M16 (RTC_KALDO_ENN), U4.N8 (DGND), U4.N9 (DGND), U5.3 (GND), U6.2 (GND), U6.5 (TESTL), U6.6 (TESTBI/GPIO/XTAMPER), U6.9 (GND), U6.12 (GPIO), U6.18 (PIRQ#), U6.19 (ATEST1*), U6.20 (TWI_WAKEUP#), U6.21 (ATEST2*), U6.23 (GND2), U6.24 (ATEST3*), U6.32 (GND), U6.EXP (GND), U7.4 (SDO/SDA0), U7.8 (RES), U7.9 (RES), U7.10 (RES), U7.11 (RES), U7.12 (GND), U7.13 (GND), U7.15 (RES), U8.1 (I2CADR0), U8.2 (I.C.), U8.3 (I2CADR1), U8.4 (VSS(PAD)), U8.9 (VSS), U8.19 (VSS(TX)), U8.27 (VSS), U8.EXP (VSS), U9.A6 (VSS), U9.C4 (VSSQ), U9.E7 (VSS), U9.G5 (VSS), U9.H10 (VSS), U9.J5 (VSS), U9.K8 (VSS), U9.N2 (VSSQ), U9.N5 (VSSQ), U9.P4 (VSSQ), U9.P6 (VSSQ), XU1.5 (GND), XU1.6 (GND), XU1.7 (GND), XU1.8 (GND), XU2.11 (VSYNC), XU2.12 (HSYNC), XU2.14 (DE), XU2.15 (DB17), XU2.16 (DB16), XU2.17 (DB15), XU2.18 (DB14), XU2.19 (DB13), XU2.20 (DB12), XU2.21 (DB11), XU2.22 (DB10), XU2.23 (DB9), XU2.24 (DB8), XU2.25 (DB7), XU2.26 (DB6), XU2.27 (DB5), XU2.28 (DB4), XU2.29 (DB3), XU2.30 (DB2), XU2.31 (DB1), XU2.32 (DB0), XU2.35 (#RD), XU2.43 (GND), XU2.48 (GND), XU2.49 (GND), XU2.50 (GND)
I2C0_SCL: U4.C10 (I2C0_SCL), U4.D10 (PMIC_SCL)
I2C0_SDA: U4.C11 (I2C0_SDA), U4.D11 (PMIC_SDA)
I2C1_SCL: R10.1, U4.B11 (UART1_TXD), U7.2 (SCL), U8.7 (I2CSCL), XU1.4 (SCL)
I2C1_SDA: R11.1, U4.A11 (UART1_RXD), U7.3 (SDA), U8.5 (I2CSDA), XU1.3 (SDA)
LCD_CLK: U4.A13 (SPI0_SCLK), XU2.36 (#WR)
LCD_CS: U4.A14 (SPI0_CS0), XU2.38 (#CS)
LCD_D/C: U4.R5 (GPMC_AD10), XU2.37 (#D/C)
LCD_MISO: U4.B13 (SPI0_D0), XU2.33 (SDO)
LCD_MOSI: U4.B14 (SPI0_D1), XU2.34 (SDI)
LCD_RESET: R9.1, U4.E1 (LCD_AC_BIAS_EN), XU1.2 (RESET), XU2.10 (RESET)
LEDA@2: RN2.8 (2), XU2.2 (LEDA)
LEDA@3: RN2.7 (2), XU2.3 (LEDA)
LEDA@4: RN2.6 (2), XU2.4 (LEDA)
LEDA@5: RN2.5 (2), XU2.5 (LEDA)
LEDK: Q1.C, XU2.1 (LEDK)
MMC0.CLK: U4.B15 (MMC0_CLK), U9.M6 (CLK)
MMC0.CMD: U4.B16 (MMC0_CMD), U9.M5 (CMD)
MMC0.D0: U4.A16 (MMC0_DAT0), U9.A3 (DAT0)
MMC0.D1: U4.A15 (MMC0_DAT1), U9.A4 (DAT1)
MMC0.D2: U4.C16 (MMC0_DAT2), U9.A5 (DAT2)
MMC0.D3: U4.C15 (MMC0_DAT3), U9.B2 (DAT3)
MMC0.D4: U4.D15 (MII1_RXD2), U9.B3 (DAT4)
MMC0.D5: U4.D14 (MII1_RXD3), U9.B4 (DAT5)
MMC0.D6: U4.E16 (MII1_RX_CLK), U9.B5 (DAT6)
MMC0.D7: U4.H16 (MII1_TX_CLK), U9.B6 (DAT7)
NC: Y2.2 (GND), Y2.4 (GND)
OSC_GND: C6.2, C7.2, U4.N15 (OSC0_GND), Y1.2 (GND), Y1.4 (GND)
PB: S1.1, S1.3 (1), U1.6 (!PB), U4.P6 (GPMC_AD12)
PB_V_REF: C2.1, U1.3 (V_REF)
PMIC1: TP2.TP, U4.N10 (PMIC_POWER_EN), U4.N11 (PMIC_PWR_EN)
PMIC2: U4.N4 (PMIC_LDO_PGOOD), U4.N5 (RTC_PWRONRSTN)
PMIC3: U4.L4 (PMIC_NWAKEUP), U4.M4 (EXT_WAKEUP)
PMIC4: U4.D4 (EXTINTN), U4.E4 (PMIC_NINT)
PMIC_MUX: U4.D6 (PMIC_MUX_OUT), U4.D7 (AIN7)
PMIC_PB: U1.8 (!PB_OUT), U4.T11 (PMIC_PB_IN)
PMIC_PGOOD: TP4.TP, U4.N12 (PMIC_PGOOD), U4.P11 (PWRONRSTN), U5.2 (A)
PMIC_TS: R1.2, U4.N6 (PMIC_TS)
PWM0A: Q1.B, RN1.4 (2), U4.A1 (MCASP0_ACLKX)
RFID_IRQ: U4.B4 (XDMA_EVENT_INTR1), U8.8 (IRQ)
RFID_MISC_1: C21.2, R20.1
RFID_MISC_2: C22.2, R21.1
RFID_OSC_IN: C17.1, U8.36 (NFC_CLK_XTAL1), Y2.1 (OSC_IN)
RFID_OSC_OUT: C16.1, U8.37 (NFC_CLK_XTAL2), Y2.3 (OSC_OUT)
RFID_RXN: C22.1, U8.15 (RXN)
RFID_RXP: C21.1, U8.16 (RXP)
RFID_TX1: L1.1, U8.21 (TX1)
RFID_TX2: L2.1, U8.18 (TX2)
RFID_VEN: TP16.TP, U4.T6 (GPMC_AD14), U8.10 (VEN)
RTC_1P8: C5.1, TP9.TP, U1.4 (PS_HOLD), U4.K11 (SYS_RTC_1P8V), U4.L11 (SYS_RTC_1P8V), U5.6 (VCC)
SIP_OSC_IN: C6.1, U4.P16 (OSC0_IN), Y1.1 (OSC_IN)
SIP_OSC_OUT: C7.1, U4.N16 (OSC0_OUT), Y1.3 (OSC_OUT)
SYS_VDD2_3P3V: TP8.TP, U4.F11 (SYS_VDD2_3P3V), U4.G11 (SYS_VDD2_3P3V)
SYS_VDD3_3P3V: TP10.TP, U4.F8 (SYS_VDD3_3P3V), U4.F9 (VDDSHV4), U4.G8 (SYS_VDD3_3P3V), U4.G9 (VDDSHV5), U4.H7 (SYS_VDD3_3P3V), U4.H8 (SYS_VDD3_3P3V), U4.H9 (VDDSHV6), U4.J7 (SYS_VDD3_3P3V), U4.J8 (SYS_VDD3_3P3V), U4.J9 (VDDSHV1), U4.K8 (SYS_VDD3_3P3V), U4.K9 (VDDSHV2), U4.L8 (SYS_VDD3_3P3V), U4.L9 (VDDSHV3)
SYS_VDD_1P8V: TP11.TP, U4.F10 (SYS_VDD_1P8V), U4.G10 (SYS_VDD_1P8V), U4.H10 (SYS_VDD_1P8V), U4.H11 (SYS_VDD_1P8V), U4.J10 (SYS_VDD_1P8V), U4.J11 (SYS_VDD_1P8V), U4.K10 (SYS_VDD_1P8V), U4.L10 (SYS_VDD_1P8V)
SYS_VOUT: TP6.TP, U4.K6 (SYS_VOUT), U4.K7 (SYS_VOUT), U4.L6 (SYS_VOUT), U4.L7 (SYS_VOUT)
TPM_SCL: R19.2, U4.A10 (UART1_RTSN), U6.29 (SM_CLK)
TPM_SDA: R18.2, U4.B10 (UART1_CTSN), U6.30 (SM_DAT)
TP_IRQ: R8.1, U4.F2 (LCD_HSYNC), XU1.1 (INT)
UART0_RX: J3.2 (RX), U4.A12 (UART0_RXD)
UART0_TX: J3.3 (TX), U4.B12 (UART0_TXD)
UART.RX_SIP.TX: U3.2 (RXD), U4.R16 (GPMC_WPN)
UART.TX_SIP.RX: U3.30 (TXD), U4.P15 (GPMC_WAIT0)
UART_3V3: C4.1, U3.1 (VCCIO), U3.16 (3V3OUT)
USB+: J2.3 (D+), U3.14 (USBDP)
USB-: J2.2 (D-), U3.15 (USBDM)
USR0: D2.A, U4.P13 (GPMC_A5)
USR1: D3.A, U4.T14 (GPMC_A6)
USR2: D4.A, U4.R14 (GPMC_A7)
USR3: D5.A, U4.P14 (GPMC_A8)
VDD: C20.1, U8.28 (VDDA), U8.29 (VDD), U8.30 (VDDD)
VDD(MID): C30.1, U8.17 (VDD(MID))
VDD(TX): C29.1, U8.14 (VDD(TX)), U8.22 (VDD(TX_IN))
VDDI: C32.1, U9.C2 (VDDI)
VDDS_DDR: TP12.TP, U4.F4 (VDDS_DDR)
VDDS_PLL: TP15.TP, U4.G13 (VDDS_PLL)
VDD_CORE: TP13.TP, U4.G4 (VDD_CORE)
VDD_MPU: TP14.TP, U4.F13 (VDD_MPU)
VIN_AC: U4.P10 (VIN_AC), U4.R10 (VIN_AC), U4.T10 (VIN_AC)
VIN_BAT: C19.1, C31.1, TP1.TP, U2.A1 (VOUT), U4.N7 (PMIC_BAT_SENSE), U4.P8 (VIN_BAT), U4.R8 (VIN_BAT), U4.T8 (VIN_BAT), U8.12 (VBAT2), U8.13 (VBAT1), U8.26 (VBAT)
VIN_USB: C3.1, J2.1 (VCC), J3.1 (VCC), U3.18 (!RESET), U3.19 (VCC), U4.P9 (VIN_USB), U4.R9 (VIN_USB), U4.T9 (VIN_USB)

Notes on the sheet:
LCD, Touchscreen and UART to USB
System in Package - A
System in Package - B
System in Package - C and D
System in Package - E and F
microSD, IMU and TPM
RFID and Antenna Matching
Low Power State Control

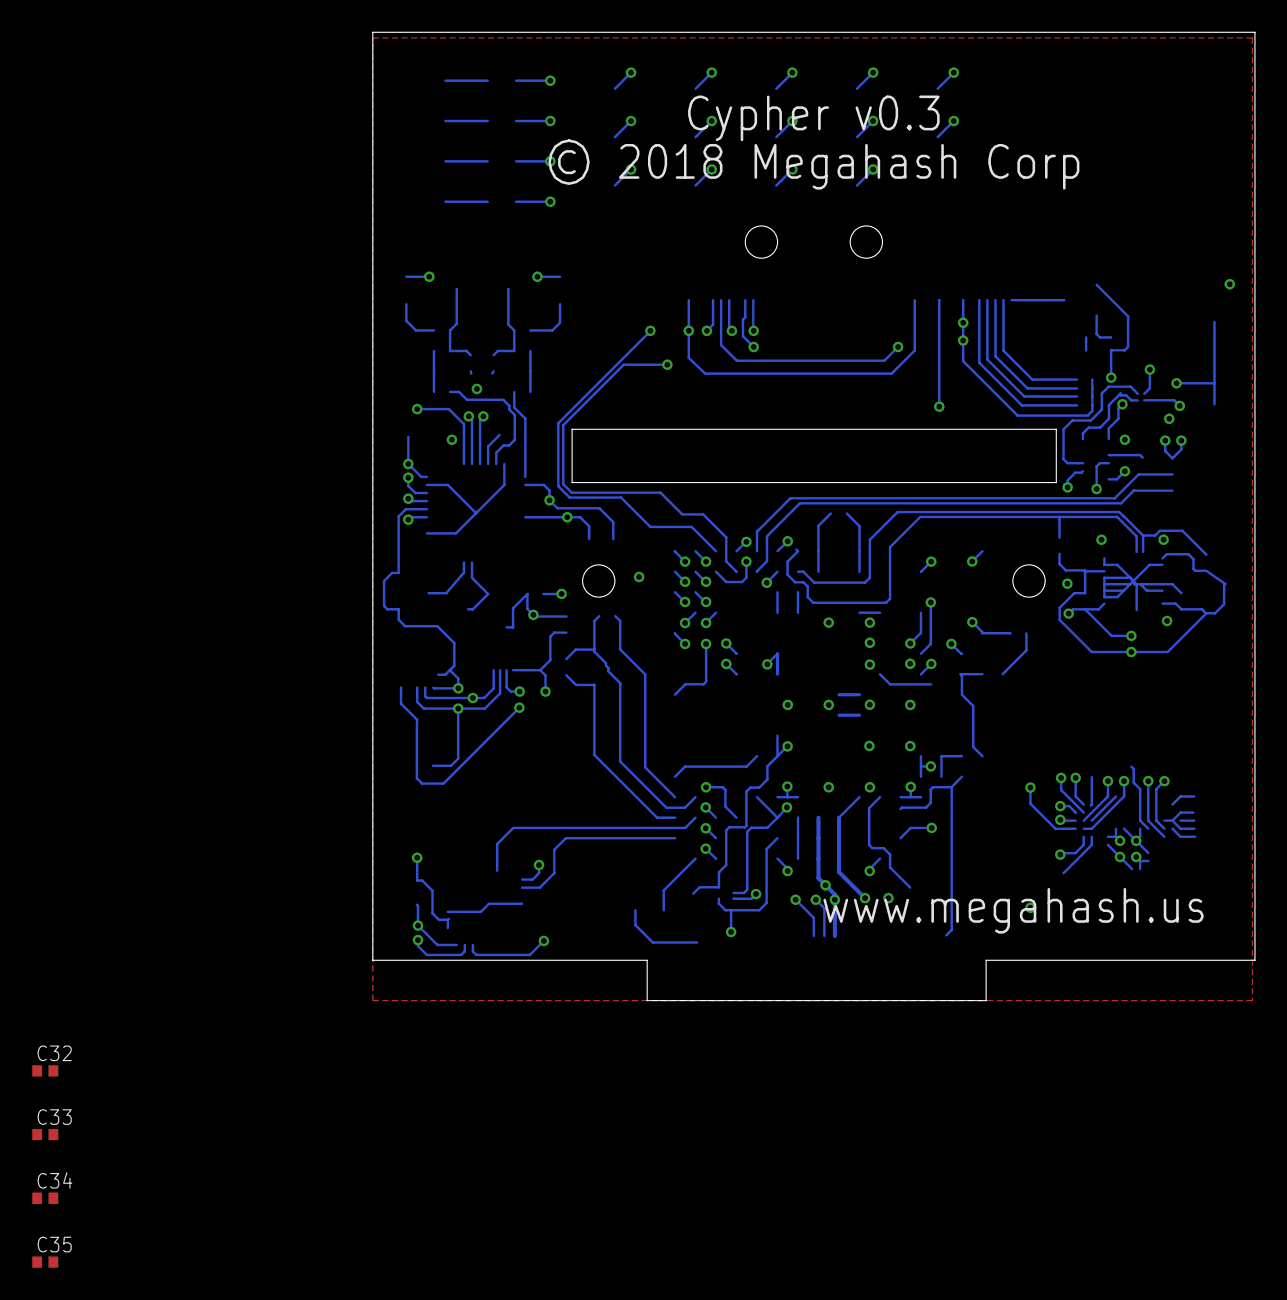
[picture p35: board Cypher - V0.4.brd from above]

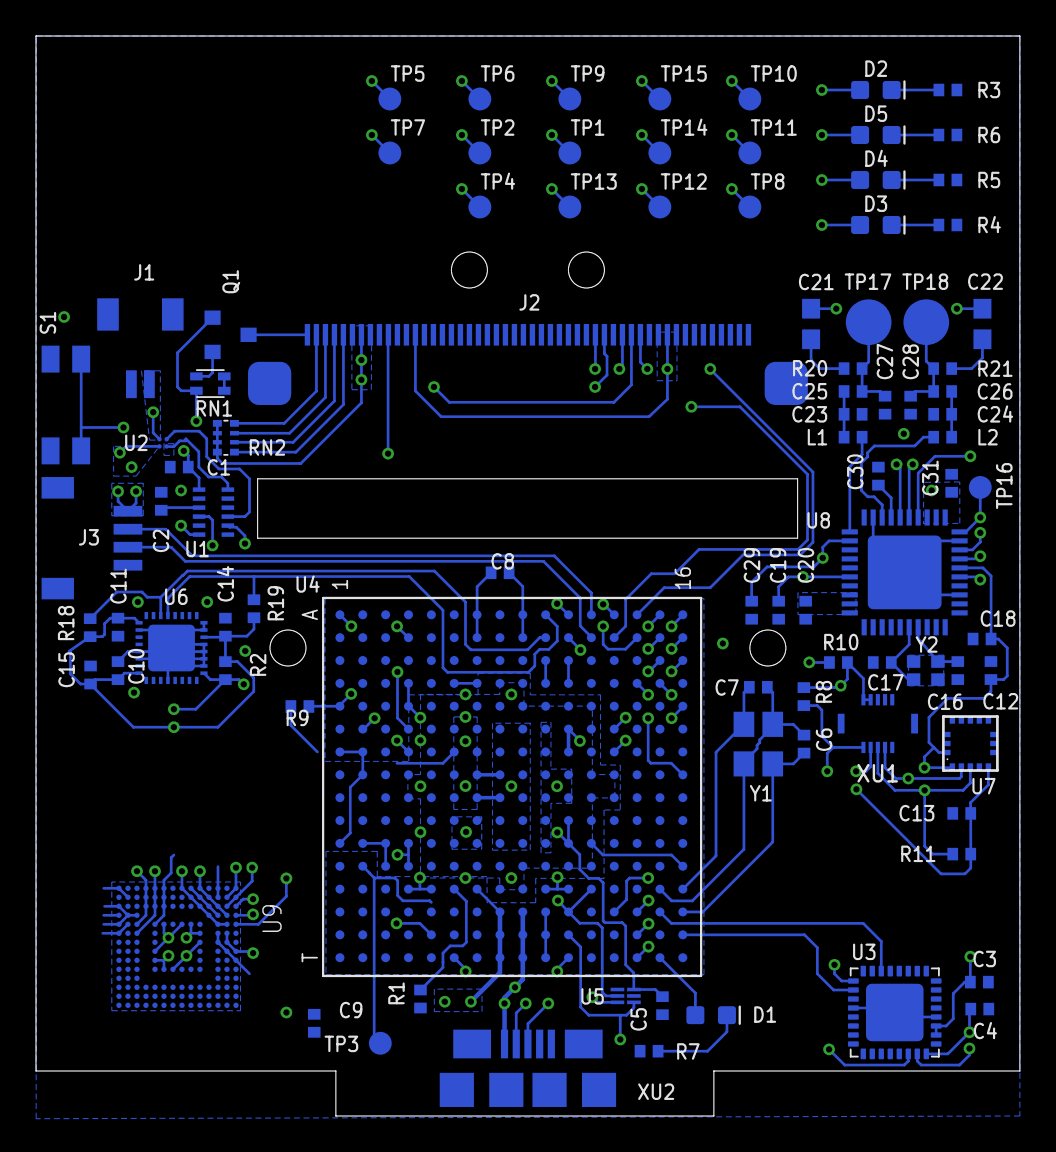
[picture p36: board Cypher - V0.4.brd from below]

Board: 4 copper layers, 54.7 x 60.0 mm, 95 parts (91 on the bottom side), 99 nets.
