intelsath/Cypher/hashbank/uboot/am335x_evm.h

/*
 * am335x_evm.h
 *
 * Copyright (C) 2011 Texas Instruments Incorporated - http://www.ti.com/
 *
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
 * This program is distributed "as is" WITHOUT ANY WARRANTY of any
 * kind, whether express or implied; without even the implied warranty
 * of MERCHANTABILITY or FITNESS FOR A PARTICULAR PURPOSE.  See the
 * GNU General Public License for more details.
 */

#ifndef __CONFIG_AM335X_EVM_H
#define __CONFIG_AM335X_EVM_H

#include <configs/ti_am335x_common.h>

#ifndef CONFIG_SPL_BUILD
# define CONFIG_TIMESTAMP
#endif

#define CONFIG_SYS_BOOTM_LEN		(16 << 20)

#define CONFIG_MACH_TYPE		MACH_TYPE_AM335XEVM

/* Clock Defines */
#define V_OSCK				24000000  /* Clock output from T2 */
#define V_SCLK				(V_OSCK)

/* Custom script for NOR */
#define CONFIG_SYS_LDSCRIPT		"board/ti/am335x/u-boot.lds"

/* Always 128 KiB env size */
#define CONFIG_ENV_SIZE			(1024 << 10)

#ifdef CONFIG_NAND
#define NANDARGS \
	"mtdids=" CONFIG_MTDIDS_DEFAULT "\0" \
	"mtdparts=" CONFIG_MTDPARTS_DEFAULT "\0" \
	"nandargs=setenv bootargs console=${console} " \
		"${optargs} " \
		"root=${nandroot} " \
		"rootfstype=${nandrootfstype}\0" \
	"nandroot=ubi0:rootfs rw ubi.mtd=NAND.file-system,2048\0" \
	"nandrootfstype=ubifs rootwait=1\0" \
	"nandboot=echo Booting from nand ...; " \
		"run nandargs; " \
		"nand read ${fdtaddr} NAND.u-boot-spl-os; " \
		"nand read ${loadaddr} NAND.kernel; " \
		"bootz ${loadaddr} - ${fdtaddr}\0"
#else
#define NANDARGS ""
#endif

#define CONFIG_ENV_VARS_UBOOT_RUNTIME_CONFIG

/* Also splash screen here */
#define BOOTENV_DEV_LEGACY_MMC(devtypeu, devtypel, instance) \
	"bootcmd_" #devtypel #instance "=" \
	"gpio set 26;" \
	"gpio set 89;" \
	"sleep 0.01;" \
	"gpio toggle 89;" \
	"sleep 0.01;" \
	"gpio toggle 89;" \
	"gpio clear 26;" \
	"sspi 0:0.0 8 E0; " \
	"gpio set 26;" \
	"sspi 0:0.0 120 00030908160A3F784C090A08161A0F;" \
	"gpio clear 26;"\
	"sspi 0:0.0 8 E1;" \
	"gpio set 26;" \
	"sspi 0:0.0 120 001619030f05324546040E0D35370F;" \
	"gpio clear 26;" \
	"sspi 0:0.0 8 C0;" \
	"gpio set 26;" \
	"sspi 0:0.0 16 1715;" \
	"gpio clear 26;" \
	"sspi 0:0.0 8 C1;" \
	"gpio set 26;" \
	"sspi 0:0.0 8 41;" \
	"gpio clear 26;" \
	"sspi 0:0.0 8 C5;" \
	"gpio set 26;" \
	"sspi 0:0.0 24 001280;" \
	"gpio clear 26;" \
	"sspi 0:0.0 8 36;" \
	"gpio set 26;" \
	"sspi 0:0.0 8 48;" \
	"gpio clear 26;" \
	"sspi 0:0.0 8 3A;" \
	"gpio set 26;" \
	"sspi 0:0.0 8 61;" \
	"gpio clear 26;" \
	"sspi 0:0.0 8 B0;" \
	"gpio set 26;" \
	"sspi 0:0.0 8 80;" \
	"gpio clear 26;" \
	"sspi 0:0.0 8 B1;" \
	"gpio set 26;" \
	"sspi 0:0.0 8 A0;" \
	"gpio clear 26;" \
	"sspi 0:0.0 8 B4;" \
	"gpio set 26;" \
	"sspi 0:0.0 8 02;" \
	"gpio clear 26;" \
	"sspi 0:0.0 8 B6;" \
	"gpio set 26;" \
	"sspi 0:0.0 16 0202;" \
	"gpio clear 26;" \
	"sspi 0:0.0 8 E9;" \
	"gpio set 26;" \
	"sspi 0:0.0 8 00;" \
	"gpio clear 26;" \
	"sspi 0:0.0 8 F7;" \
	"gpio set 26;" \
	"sspi 0:0.0 32 A9512C82;" \
	"gpio clear 26;" \
	"sspi 0:0.0 8 11;" \
	"sleep 0.12;" \
	"sspi 0:0.0 8 29;" \
	"sleep 0.12;" \
	"sspi 0:0.0 8 2A;" \
	"gpio set 26;" \
	"sspi 0:0.0 32 0000013F;" \
	"gpio clear 26;" \
	"sspi 0:0.0 8 2B;" \
	"gpio set 26;" \
	"sspi 0:0.0 32 000001DF;" \
	"gpio clear 26;" \
	"sspi 0:0.0 8 2C; " \
	"sleep 0.12;" \
	"sspi 0:0.0 8 3C; " \
	"sleep 0.12;" \
	"gpio set 26; " \
	"sspi 0:0.0 614400 0000000000000000000000000000000000000000000000000000000000000000000000000000000000000000000000000000000000000000000000000000000000000000000000000000000000000000000000000000000000000000000000000000000000000000000000000000000000000000000000000000000000000000000000000000000000000000000000000000000000000000000000000000000000000000000000000000000000000000000000000000000000000000000000000000000000000000000000000000000000000000000000000000000000000000000000000000000000000000000000000000000000000000000000000000000000000000000000000000000000000000000000000000000000000000000000000000000000000000000000000000000000000000000000000000000000000000000000000000000000000000000000000000000000000000000000000000000000000000000000000000000000000000000000000000000000000000000000000000000000000000000000000000000000000000000000000000000000000000000000000000000000000000000000000000000000000000000000000000000000000000000000000000000000000000000000000000000000000000000000000000000000000000000000000000000000000000000000000000000000000000000000000000000000000000000000000000000000000000000000000000000000000000000000000000000000000000000000000000000000000000000000000000000000000000000000000000000000000000000000000000000000000000000000000000000000000000000000000000000000000000000000000000000000000000000000000000000000000000000000000000000000000000000000000000000000000000000000000000000000000000000000000000000000000000000000000000000000000000000000000000000000000000000000000000000000000000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
