intelsath/Cypher/(commit log)

2020-03-15 All code and schematics
    [0603 LED v7.0001.ipt, 0603 LED v7.ipt, Antenna.0001.ipt, Antenna.ipt, Assembled_PCB.0011.iam, Assembled_PCB.iam, Battery.0009.ipt, Battery.ipt]
2020-03-15 Embedded Code
    [Cypher-BOM.xls, Cypher.brd, Cypher.sch]
