intelsath/Cypher/(notices)

Notices in the files:
hashbank/uboot/am335x_evm.h:
modify it under the terms of the GNU General Public License as
published by the Free Software Foundation version 2.
parts and their libraries:
SparkFun-LED: Licensing: Creative Commons ShareAlike 4.0 International - https://creativecommons.org/licenses/by-sa/4.0
